carlosgj/openEEG/Eagle/Pinout.xlsx

1 | AGND
2 | VCOM
3 | VREF
4 | AGND
5 | VCOM
6 | AGND
7 | SCK
8 | SDO 0
9 | SDO 3
10 | SDO 5
11 | SDO 7
12 | SDO 9
13 | SDO 11
14 | AGND
15 | RLD
16 | AGND
17 | 5V
18 | AGND
19 | CNV
20 | SDO 1
21 | SDO 2
22 | SDO 4
23 | SDO 6
24 | SDO 8
25 | SDO 10
