carlosgj/openEEG/BOM.xlsx

Qty | Value | Device | Package | Parts | Description | PN | Price | Line
1 | 220nf | C-EUC1206 | C1206 | C1 | CAPACITOR, European symbol | 594-K224K20X7RF5TH5 (http://www.mouser.com/ProductDetail/Vishay-BC-Components/K224K20X7RF5TH5/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) | $0.19 | $0.19
8 | 100nF | C-EUC1206 | C1206 | C18, C19, C20, C21, C215, C218, C223, C230 | CAPACITOR, European symbol | 594-K104K15X7RF53L2 (http://www.mouser.com/ProductDetail/Vishay-BC-Components/K104K15X7RF53L2/) | $0.10 | $0.80
2 | 100pF | C-EUC1206 | C1206 | C206, C207 | CAPACITOR, European symbol | 594-S101K29SL0N6TK5R (http://www.mouser.com/ProductDetail/Vishay-BC-Components/S101K29SL0N6TK5R/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) | $0.11 | $0.22
1 | 10pF | C-EUC1206 | C1206 | C210 | CAPACITOR, European symbol | 594-S100K25SL0N63L6R (http://www.mouser.com/ProductDetail/Vishay-BC-Components/S100K25SL0N63L6R/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) | $0.15 | $0.15
2 | 1µF | C-EU050-024X044 | C050-024X044 | C221, C228 | CAPACITOR, European symbol | 594-K105K20X7RF5TH5 (http://www.mouser.com/ProductDetail/Vishay-BC-Components/K105K20X7RF5TH5/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) | $0.39 | $0.78
2 | 1nF | C-EUC1206 | C1206 | C224, C233 | CAPACITOR, European symbol | 594-K102J15C0GF53H5 (http://www.mouser.com/ProductDetail/Vishay-BC-Components/K102J15C0GF53H5/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) | $0.18 | $0.36
1 | 220nF 5% | C-EUC1206 | C1206 | C235 | CAPACITOR, European symbol | 810-FG22C0G1H224JNT6 (http://www.mouser.com/ProductDetail/TDK/FG22C0G1H224JNT06/) | $1.32 | $1.32
1 | 33nF 5% | C-EUC1206 | C1206 | C236 | CAPACITOR, European symbol | 810-FG24C0G1H333JNT6 (http://www.mouser.com/ProductDetail/TDK/FG24C0G1H333JNT06/) | $0.73 | $0.73
1 | INA217DW | INA217DW | DW_RPDSO-G16 | IC2 | Low-Noise, Low-Distortion INSTRUMENTATION AMPLIFIER Replacement for SSM2017 | 595-INA217AIDWT (http://www.mouser.com/ProductDetail/Texas-Instruments/INA217AIDWT/) | $6.44 | $6.44
1 | 20k | S64Y | S64Y | P203 |  | 652-3296W-1-203LF (http://www.mouser.com/ProductDetail/Bourns/3296W-1-203LF/) | $2.41 | $2.41
2 | BC557 | BC557 | TO92 | Q202, Q204 |  | 512-BC557BTA (http://www.mouser.com/ProductDetail/Fairchild-Semiconductor/BC557BTA/) | $0.21 | $0.42
2 | BC547 | BC547 | TO92 | Q206, Q208 |  | 512-BC547BTA (http://www.mouser.com/Search/ProductDetail.aspx?R=BC547BTAvirtualkey51210000virtualkey512-BC547BTA) | $0.18 | $0.36
8 | 2k2 | R-US_R1206 | R1206 | R203, R204, R209, R210, R211, R212, R216, R217 | RESISTOR, American symbol | 660-MF1/4LCT52R222J (http://www.mouser.com/ProductDetail/KOA-Speer/MF1-4LCT52R222J/) | $0.10 | $0.80
1 | 1k | R-US_R1206 | R1206 | R222 | RESISTOR, American symbol | 660-MS1/2DCT52R1001 (http://www.mouser.com/ProductDetail/KOA-Speer/MFS1-2DCT52R1001F/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) | $0.10 | $0.10
2 | 100k | R-US_R1206 | R1206 | R225, R235 | RESISTOR, American symbol | 660-MF1/4LCT52R104J (http://www.mouser.com/ProductDetail/KOA-Speer/MF1-4LCT52R104J/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) | $0.10 | $0.20
2 | 1M | R-US_R1206 | R1206 | R226, R236 | RESISTOR, American symbol | 660-MF1/4LCT52R105J (http://www.mouser.com/ProductDetail/KOA-Speer/MF1-4LCT52R105J/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) | $0.10 | $0.20
1 | 15k | R-US_R1206 | R1206 | R233 | RESISTOR, American symbol | 660-MFS1/4DCT52R1502 (http://www.mouser.com/ProductDetail/KOA-Speer/MFS1-4DCT52R1502F/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) | $0.10 | $0.10
1 | 8.2k | R-US_R1206 | R1206 | R234 | RESISTOR, American symbol | 660-MF1/4DCT52R8201F (http://www.mouser.com/ProductDetail/KOA-Speer/MF1-4DCT52R8201F/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) | $0.12 | $0.12
1 | 10k | R-US_R1206 | R1206 | R237 | RESISTOR, American symbol | 660-MF1/4LCT52R103J (http://www.mouser.com/ProductDetail/KOA-Speer/MF1-4LCT52R103J/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) | $0.10 | $0.10
1 | 7.5k | R-US_R1206 | R1206 | R3 | RESISTOR, American symbol | 660-MF1/4LCT52R752J (http://www.mouser.com/ProductDetail/KOA-Speer/MF1-4LCT52R752J/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) | $0.10 | $0.10
3 | AD8021 | AD8021 | SOIC8 | U$2, U$3, U$16 |  | 584-AD8021ARZ (http://www.mouser.com/ProductDetail/Analog-Devices/AD8021ARZ/?qs=sGAEpiMZZMv9Q1JI0Mo%2ftWybF53LRrMK) | $3.37 | $10.11
 |  |  |  |  |  |  |  | $26.01
