carlosgj/openEEG/CAD/modEEG.SLDASM

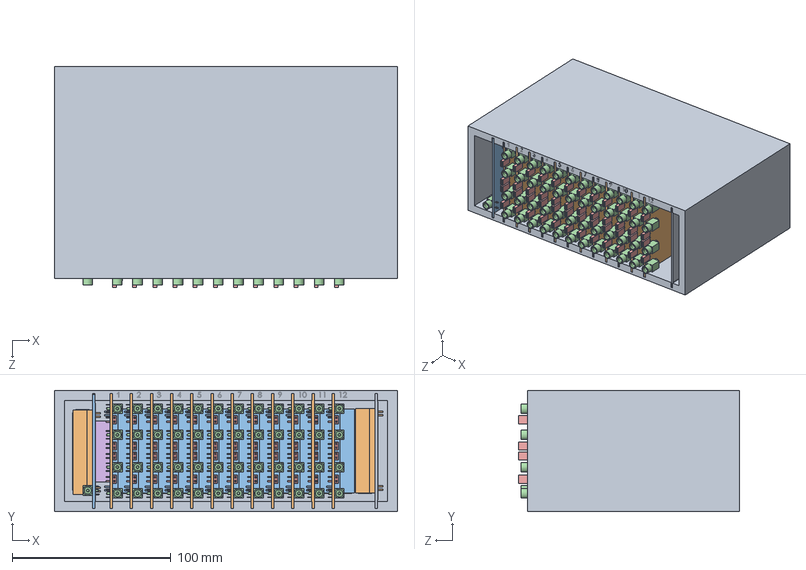
[picture p9: CAD file, 2016-11-03]
CAD/modEEG.SLDASM
215.9 x 76.2 x 138.9 mm
Enclosure
Amp PCB x 12
DB25FR x 12
EEG Jack Rt-Angle x 49
2 Pin Female Header x 48
Backplane PCB
DB25MV x 12
DB25FV x 2
Digital PCB
DB25MR x 2
Refgen PCB
