carlosgj/openEEG/CAD/Backplane.SLDASM

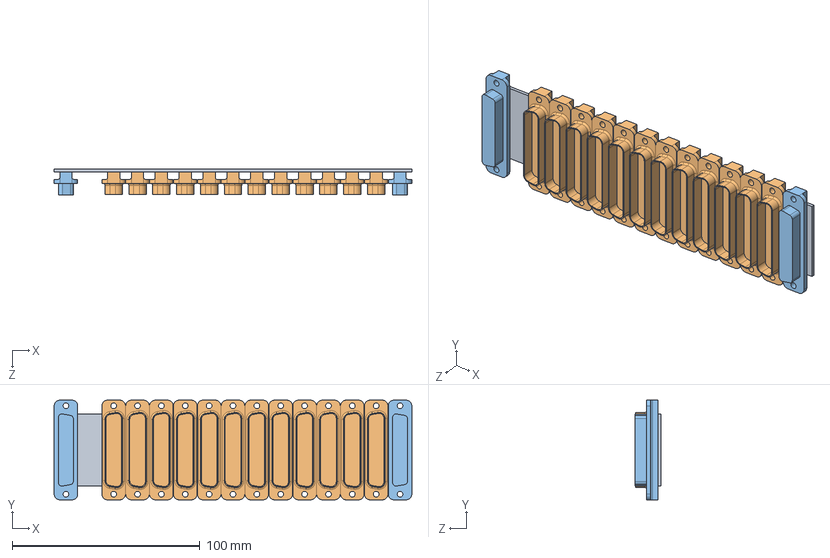
[picture p10: CAD file, 2016-11-03]
CAD/Backplane.SLDASM
190.5 x 53.0 x 13.6 mm
Backplane PCB
DB25MV x 12
DB25FV x 2
