carlosgj/openEEG/CAD/Refgen.SLDASM

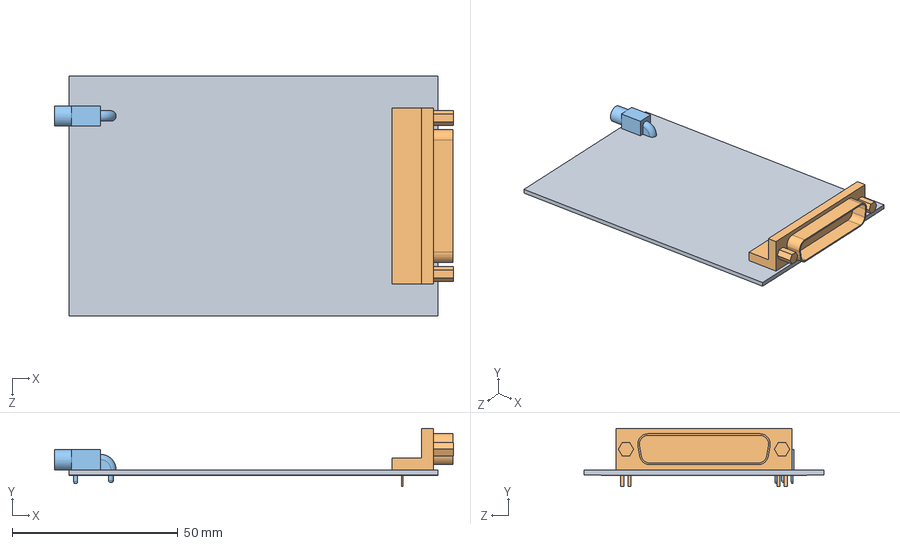
[picture p11: CAD file, 2016-11-03]
CAD/Refgen.SLDASM
120.3 x 17.5 x 72.4 mm
Refgen PCB
DB25MR
EEG Jack Rt-Angle
