carlosgj/openEEG/CAD/Amp.SLDASM

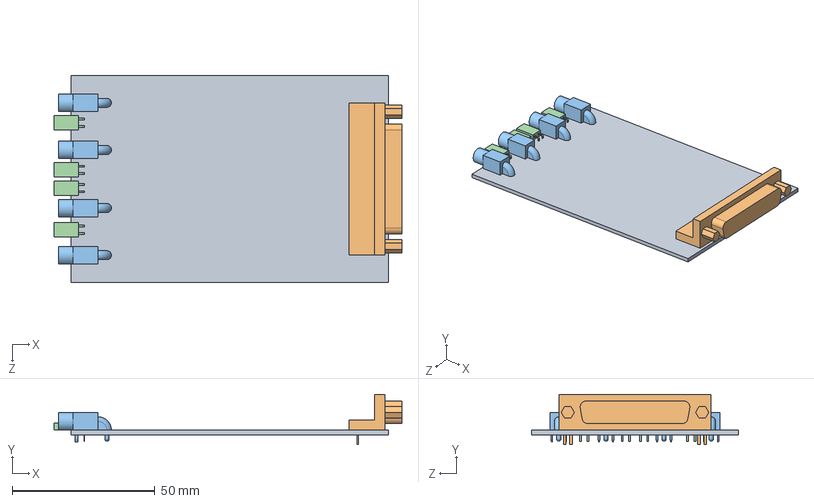
[picture p12: CAD file, 2016-11-03]
CAD/Amp.SLDASM
121.8 x 17.5 x 72.4 mm
Amp PCB
DB25FR
EEG Jack Rt-Angle x 4
2 Pin Female Header x 4
