carlosgj/openEEG/CAD/Refgen PCB.SLDPRT

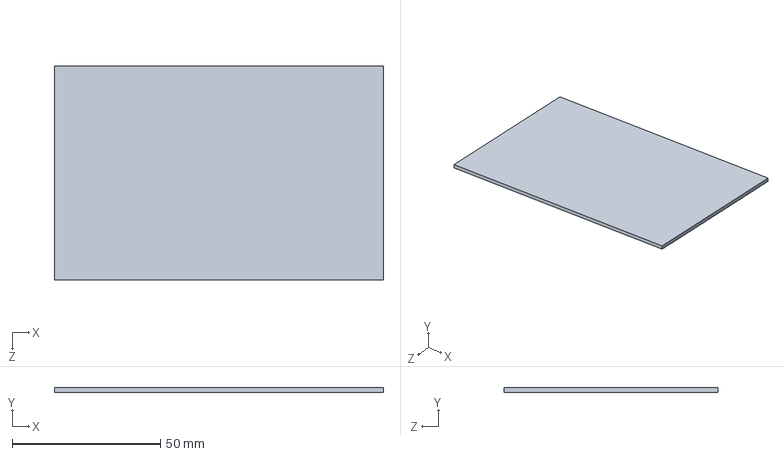
[picture p13: CAD file, 2016-11-03]
CAD/Refgen PCB.SLDPRT
111.1 x 1.64 x 72.4 mm
