carlosgj/openEEG/EEG Jack Rt-Angle.SLDPRT

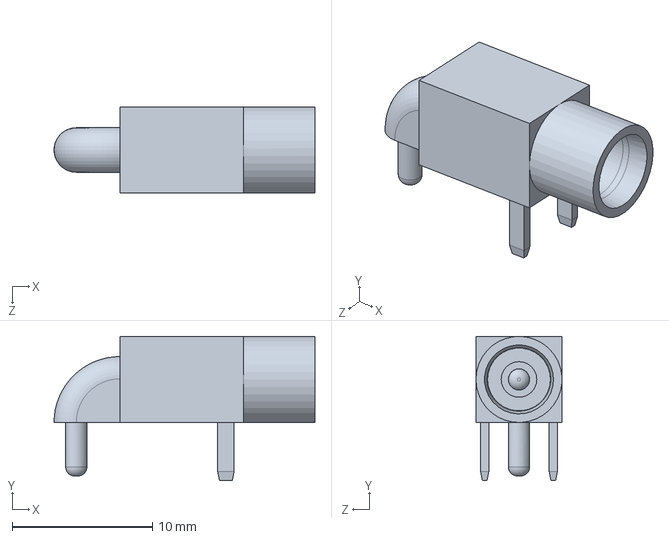
[picture p14: CAD file, 2016-11-03]
EEG Jack Rt-Angle.SLDPRT
18.6 x 10.3 x 6.13 mm
