carlosgj/openEEG/CAD/Enclosure.SLDPRT

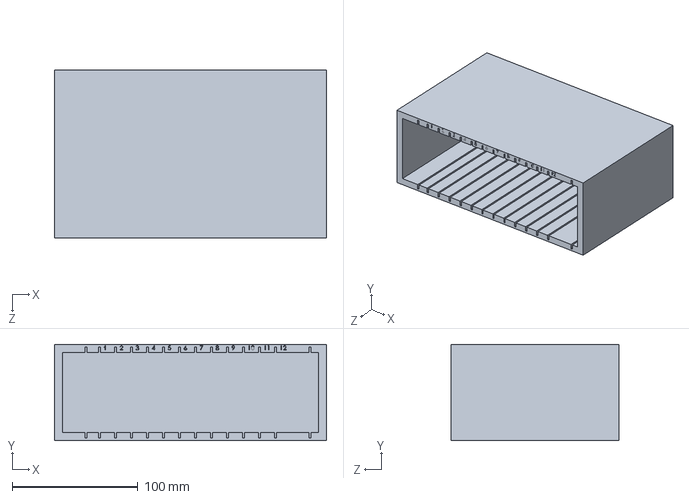
[picture p15: CAD file, 2016-11-03]
CAD/Enclosure.SLDPRT
215.9 x 76.2 x 133.4 mm
