carlosgj/openEEG/CAD/Backplane PCB.SLDPRT

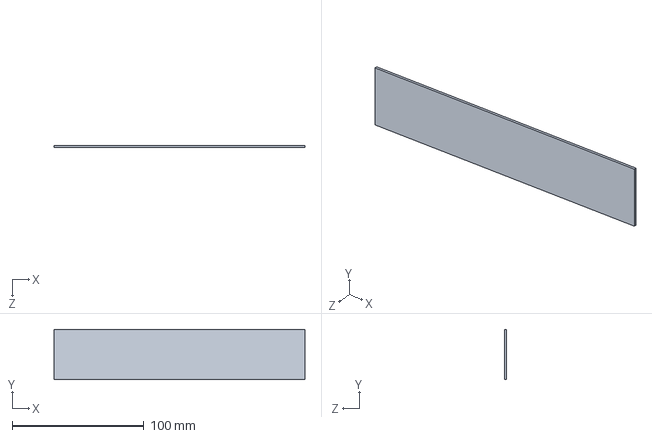
[picture p16: CAD file, 2016-11-03]
CAD/Backplane PCB.SLDPRT
190.5 x 38.1 x 1.59 mm
