carlosgj/openEEG/CAD/Amp PCB.SLDPRT

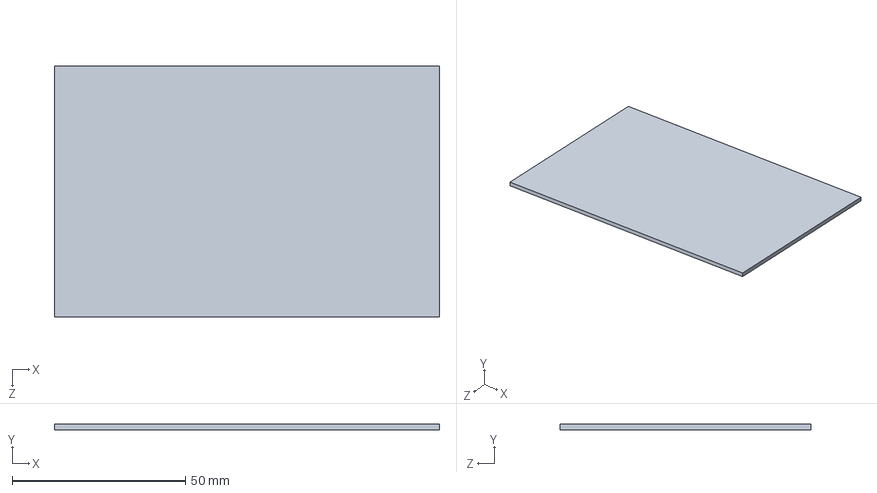
[picture p17: CAD file, 2016-11-03]
CAD/Amp PCB.SLDPRT
111.1 x 1.59 x 72.4 mm
