carlosgj/openEEG/CAD/2 Pin Female Header.SLDPRT

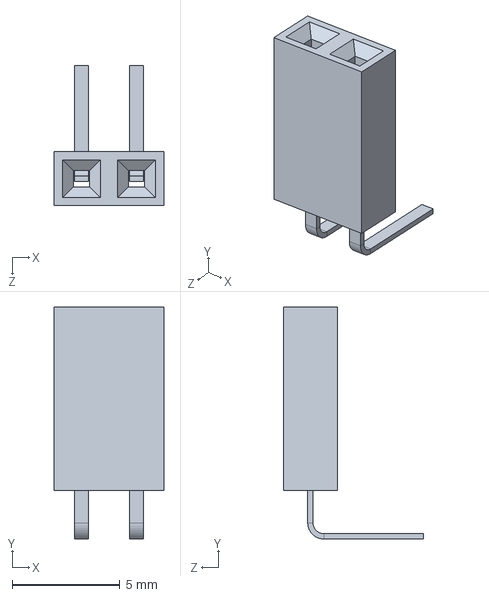
[picture p18: CAD file, 2016-11-03]
CAD/2 Pin Female Header.SLDPRT
5.08 x 10.8 x 6.50 mm
