carlosgj/openEEG/CAD/DB25FV.SLDPRT

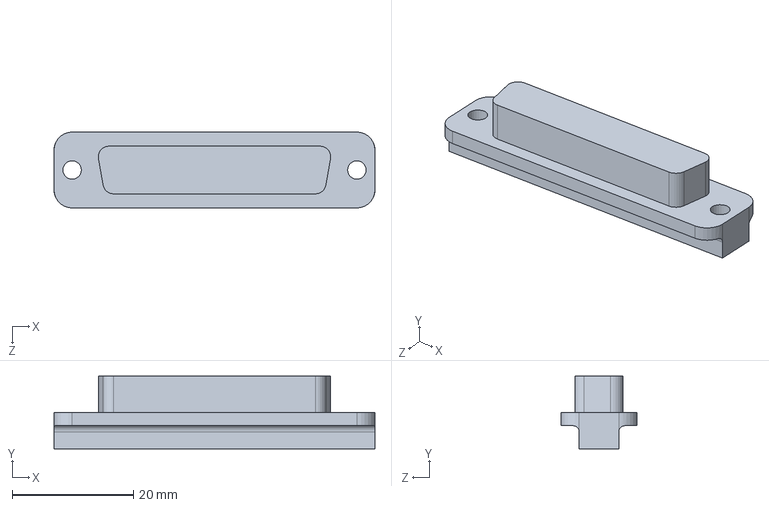
[picture p19: CAD file, 2016-11-02]
CAD/DB25FV.SLDPRT
53.0 x 12.0 x 12.6 mm
