carlosgj/openEEG/CAD/DB25MV.SLDPRT

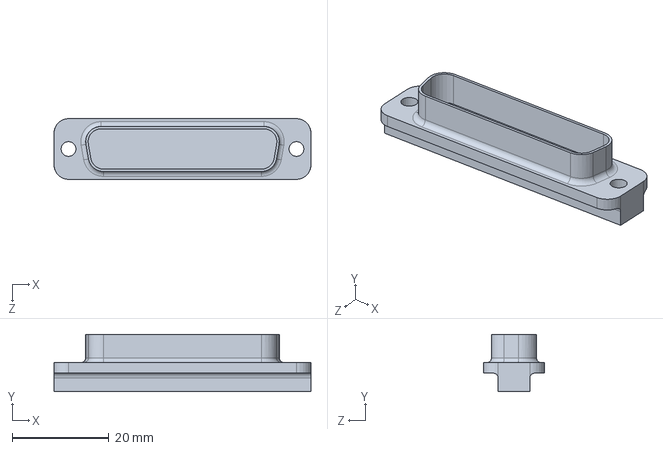
[picture p20: CAD file, 2016-11-02]
CAD/DB25MV.SLDPRT
53.0 x 11.8 x 12.6 mm
