carlosgj/openEEG/CAD/DB25MR.SLDPRT

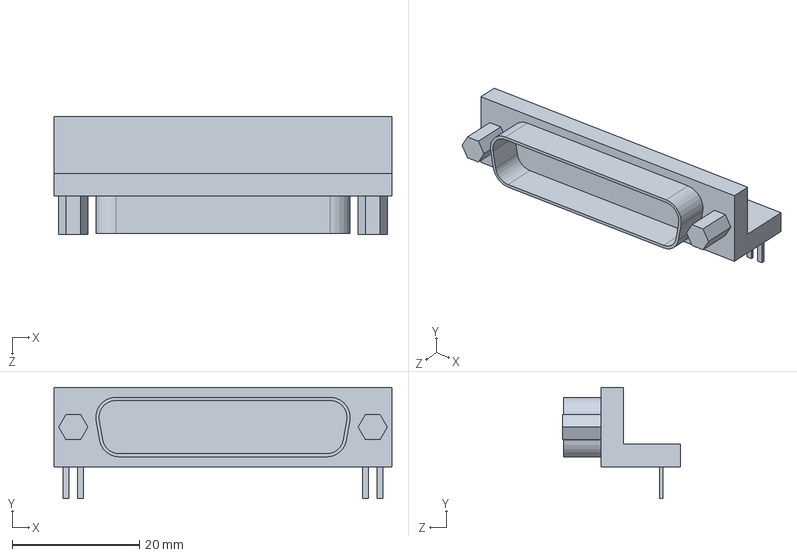
[picture p21: CAD file, 2016-11-02]
CAD/DB25MR.SLDPRT
53.1 x 17.5 x 18.5 mm
