carlosgj/openEEG/CAD/DB25FR.SLDPRT

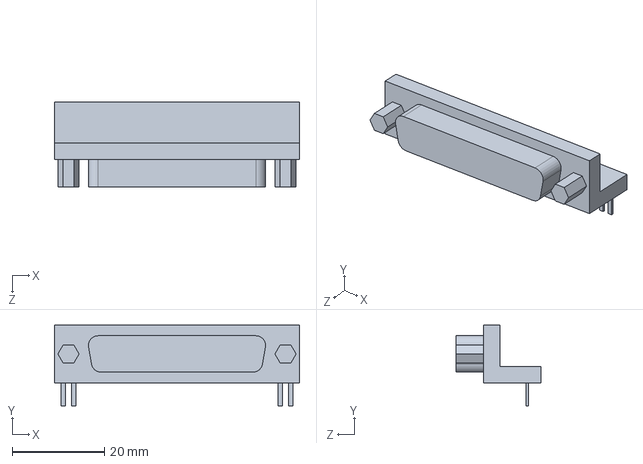
[picture p22: CAD file, 2016-11-02]
CAD/DB25FR.SLDPRT
53.1 x 17.5 x 18.5 mm
