carlosgj/openEEG/(list of files, cad)

Other CAD files:
CAD/Digital.SLDASM
modEEG.X/dist/default/production/modEEG.X.production.obj
CAD/Digital PCB.SLDPRT
CAD/DB25F.SLDPRT
