carlosgj/openEEG/Eagle/modEEGamp_v1.1 - Single.brd

## EAGLE design Eagle/modEEGamp_v1.1 - Single.brd (2017-01-04)

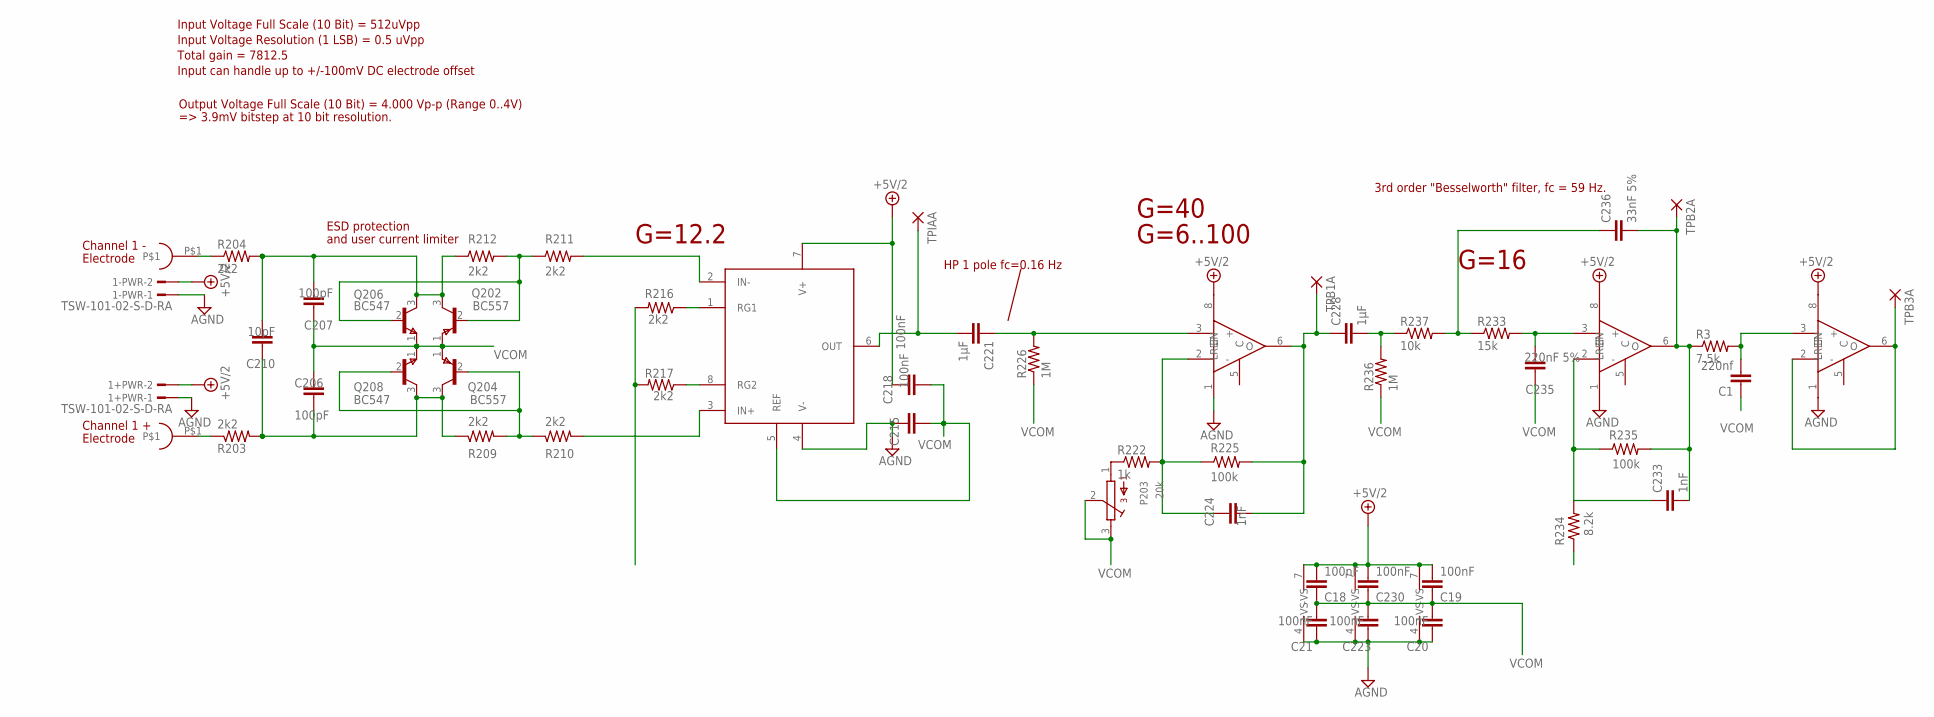
[picture p23: schematic modEEGamp_v1.1 - Single.sch]

Parts:
1+PWR, 1-PWR: TSW-101-02-S-D-RA
C1: 220nf; C1206
C1+, C1-: DIN42802
C18, C19, C20, C21, C215, C218, C223, C230: 100nF; C1206
C206, C207: 100pF; C1206
C210: 10pF; C1206
C221, C228: 1µF; C050-024X044
C224, C233: 1nF; C1206
C235: 220nF 5%; C1206
C236: 33nF 5%; C1206
P203: 20k; S64Y
Q202, Q204: BC557; TO92
Q206, Q208: BC547; TO92
R3: 7.5k; R1206
R203, R204, R209, R210, R211, R212, R216, R217: 2k2; R1206
R222: 1k; R1206
R225, R235: 100k; R1206
R226, R236: 1M; R1206
R233: 15k; R1206
R234: 8.2k; R1206
R237: 10k; R1206
TPB1A, TPB2A, TPB3A: 1,6/0,8
TPIAA: 1,6/0,8
U$1: INA217; DIL-08
U$2, U$3, U$16: AD8021; SOIC8

Connections:
+5V/2: 1+PWR.2, 1-PWR.2, C18.2, C19.2, C218.1, C230.2, U$1.7 (V+), U$2.7 (+VS), U$2.8 (EN), U$3.7 (+VS), U$3.8 (EN), U$16.7 (+VS), U$16.8 (EN)
ADIN0: TPB3A.1, U$16.2 (-), U$16.6 (O)
AGND: 1+PWR.1, 1-PWR.1, C20.1, C21.1, C215.1, C223.1, U$1.4 (V-), U$2.1 (LREF), U$2.4 (-VS), U$3.1 (LREF), U$3.4 (-VS), U$16.1 (LREF), U$16.4 (-VS)
unnamed: R216.1, U$1.1 (RG1)
unnamed: R217.1, U$1.8 (RG2)
unnamed: C233.2, C236.2, R3.1, R235.2, TPB2A.1, U$3.6 (O)
unnamed: C1-.P$1, R204.1
unnamed: C1.2, R3.2, U$16.3 (+)
unnamed: C1+.P$1, R203.1
unnamed: R216.2, R217.2
unnamed: R211.2, U$1.2 (IN-)
unnamed: C221.2, TPIAA.1, U$1.6 (OUT)
unnamed: R210.2, U$1.3 (IN+)
unnamed: C221.1, R226.2, U$2.3 (+)
unnamed: Q202.2 (B), Q206.2 (B), R211.1, R212.2
unnamed: C207.2, C210.2, Q202.3 (C), Q206.3 (C), R204.2, R212.1
unnamed: C224.1, R222.2, R225.1, U$2.2 (-)
unnamed: Q204.2 (B), Q208.2 (B), R209.2, R210.1
unnamed: P203.1, R222.1
unnamed: C224.2, C228.1, R225.2, TPB1A.1, U$2.6 (O)
unnamed: C206.1, C210.1, Q204.3 (C), Q208.3 (C), R203.2, R209.1
unnamed: C233.1, R234.2, R235.1, U$3.2 (-)
unnamed: C228.2, R236.2, R237.1
unnamed: C236.1, R233.1, R237.2
unnamed: C235.2, R233.2, U$3.3 (+)
VCOM: C1.1, C18.1, C19.1, C20.2, C21.2, C206.2, C207.1, C215.2, C218.2, C223.2, C230.1, C235.1, P203.2, P203.3, Q202.1 (E), Q204.1 (E), Q206.1 (E), Q208.1 (E), R226.1, R234.1, R236.1, U$1.5 (REF)

Notes on the sheet:
Electrode
Channel 1 -
Channel 1 +
Output Voltage Full Scale (10 Bit) = 4.000 Vp-p (Range 0..4V)
HP 1 pole fc=0.16 Hz
ESD protection
and user current limiter
G=12.2
G=16
G=40
G=6..100
Total gain = 7812.5
Input Voltage Resolution (1 LSB) = 0.5 uVpp
Input Voltage Full Scale (10 Bit) = 512uVpp
Input can handle up to +/-100mV DC electrode offset
3rd order "Besselworth" filter, fc = 59 Hz.
=> 3.9mV bitstep at 10 bit resolution.

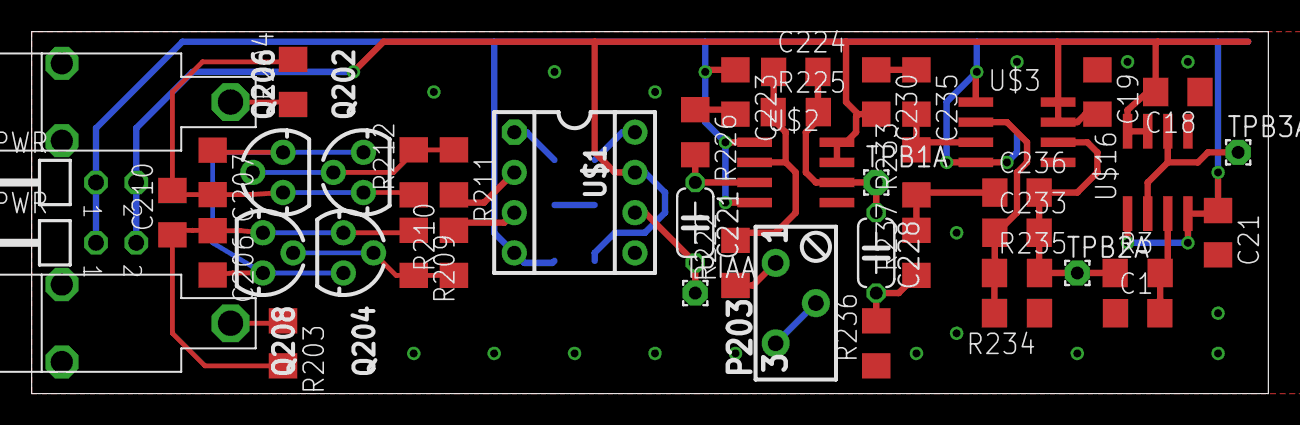
[picture p24: board modEEGamp_v1.1 - Single.brd from above]

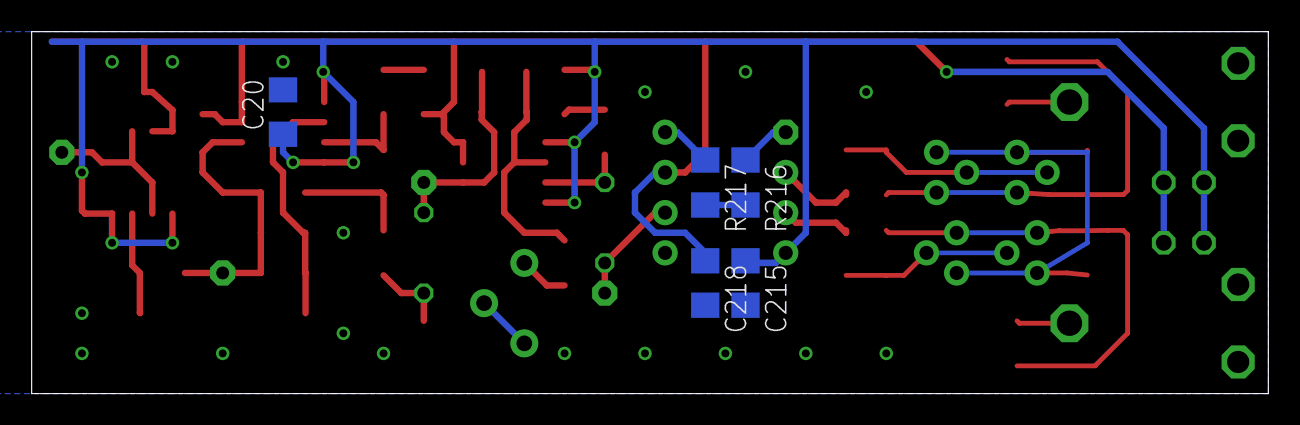
[picture p25: board modEEGamp_v1.1 - Single.brd from below]

Board: 2 copper layers, 78.1 x 22.9 mm, 52 parts (5 on the bottom side), 26 nets.
