carlosgj/openEEG/Eagle/modEEGamp_v1.1.brd

## EAGLE design Eagle/modEEGamp_v1.1.brd (2016-12-14)

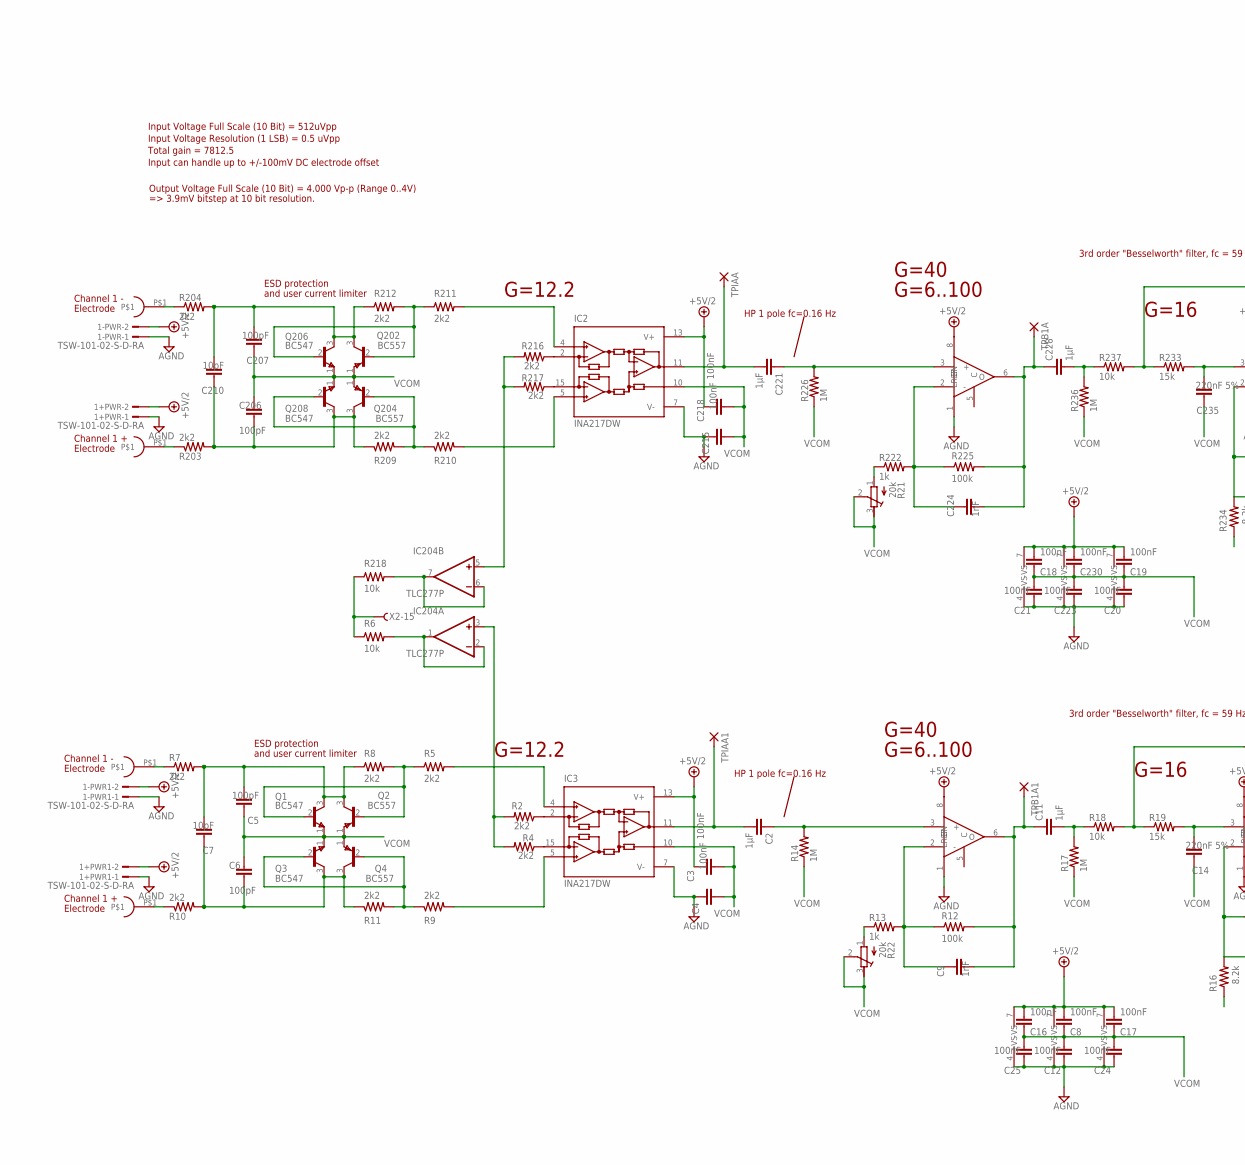
[picture p26: schematic modEEGamp_v1.1.sch, part in row 1, column 1]

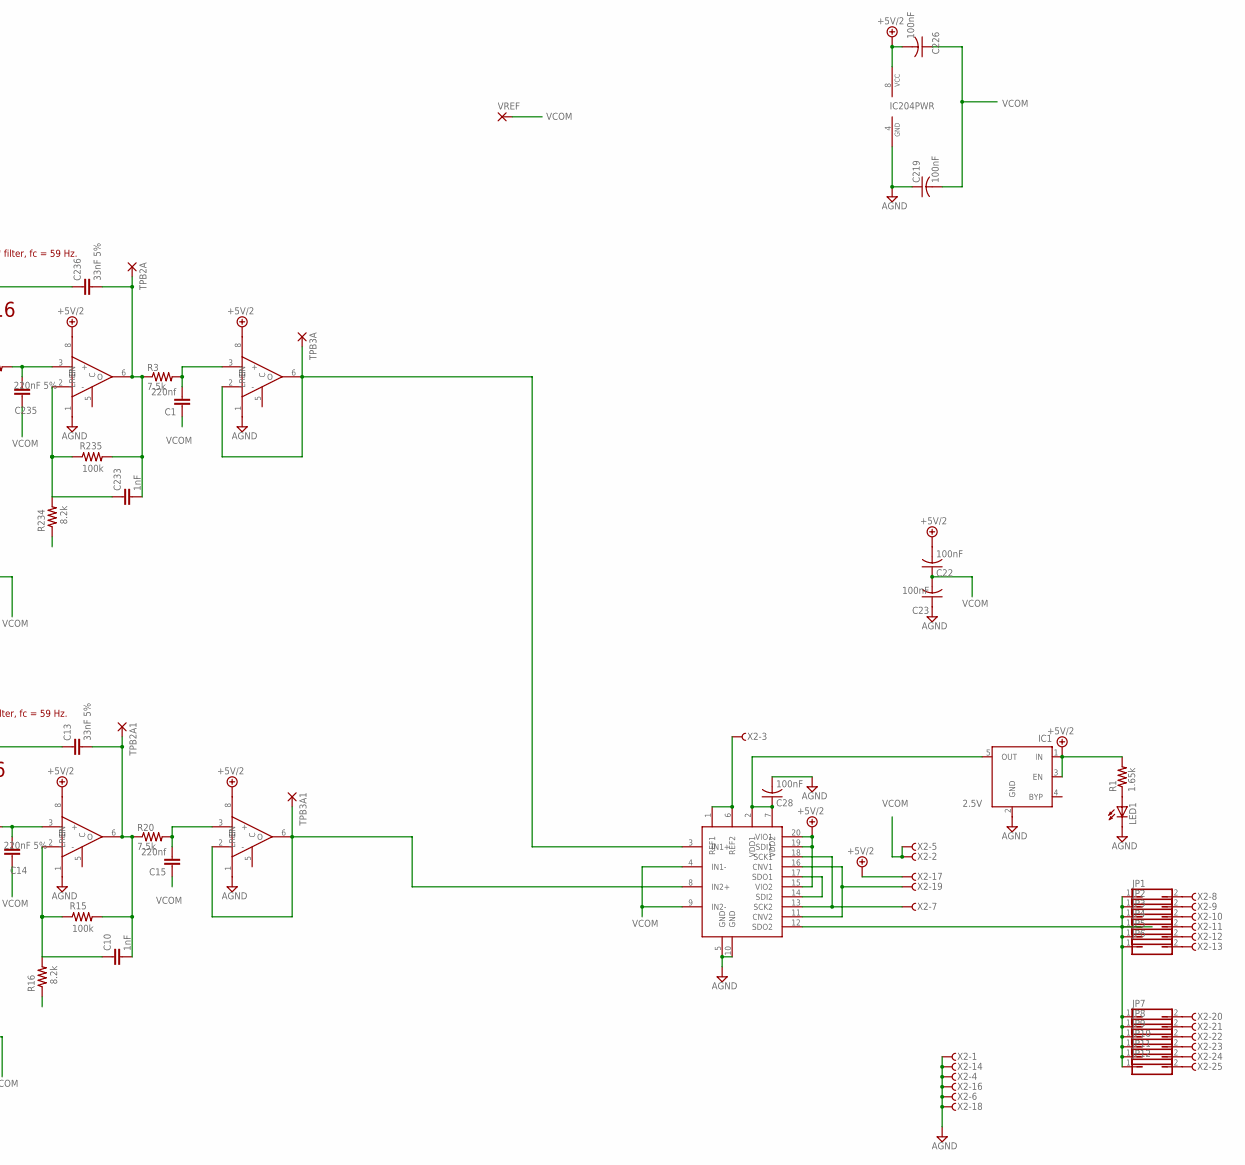
[picture p27: schematic modEEGamp_v1.1.sch, part in row 1, column 2]

Parts:
1+PWR, 1+PWR1, 1-PWR, 1-PWR1: TSW-101-02-S-D-RA
C1, C15: 220nf; C1206
C1+, C1+1, C1-, C1-1: DIN42802
C2, C11, C221, C228: 1µF; C050-024X044
C3, C4, C8, C12, C16, C17, C18, C19, C20, C21, C22, C23, C24, C25, C28, C215, C218, C219, C223, C226, C230: 100nF; C1206
C5, C6, C206, C207: 100pF; C1206
C7, C210: 10pF; C1206
C9, C10, C224, C233: 1nF; C1206
C13, C236: 33nF 5%; C1206
C14, C235: 220nF 5%; C1206
IC1: 2.5V; SOT23-5
IC2, IC3: INA217DW; DW_RPDSO-G16
IC204: TLC277P; DIL-08
JP1, JP2, JP3, JP4, JP5, JP6, JP7, JP8, JP9, JP10, JP11, JP12: JP1Q; JP1
LED1: LED3MM
Q1, Q3, Q206, Q208: BC547; TO92
Q2, Q4, Q202, Q204: BC557; TO92
R1: 1.65k; R1206
R2, R4, R5, R7, R8, R9, R10, R11, R203, R204, R209, R210, R211, R212, R216, R217: 2k2; R1206
R3, R20: 7.5k; R1206
R6, R18, R218, R237: 10k; R1206
R12, R15, R225, R235: 100k; R1206
R13, R222: 1k; R1206
R14, R17, R226, R236: 1M; R1206
R16, R234: 8.2k; R1206
R19, R233: 15k; R1206
R21, R22: 20k; RTRIM3296W
TPB1A, TPB1A1, TPB2A, TPB2A1, TPB3A, TPB3A1: 1,6/0,8
TPIAA, TPIAA1: 1,6/0,8
U$1: AD7902; QSOP20
U$10, U$12, U$20, U$30, U$31, U$36: AD8021; SOIC8
VREF: 1,6/0,8
X2: F25HPS; F25HP

Connections:
+5V/2: 1+PWR.2, 1+PWR1.2, 1-PWR.2, 1-PWR1.2, C3.1, C8.2, C16.2, C17.2, C18.2, C19.2, C22.2, C218.1, C226.2, C230.2, IC1.1 (IN), IC1.3 (EN), IC2.13 (V+), IC3.13 (V+), IC204.8 (VCC), R1.2, U$1.15 (VIO2), U$1.19 (SDI1), U$1.20 (VIO1), U$10.7 (+VS), U$10.8 (EN), U$12.7 (+VS), U$12.8 (EN), U$20.7 (+VS), U$20.8 (EN), U$30.7 (+VS), U$30.8 (EN), U$31.7 (+VS), U$31.8 (EN), U$36.7 (+VS), U$36.8 (EN), X2.17
ADIN0: TPB3A.1, U$1.3 (IN1+), U$20.2 (-), U$20.6 (O)
ADIN1: TPB3A1.1, U$1.8 (IN2+), U$36.2 (-), U$36.6 (O)
AGND: 1+PWR.1, 1+PWR1.1, 1-PWR.1, 1-PWR1.1, C4.1, C12.1, C20.1, C21.1, C23.1, C24.1, C25.1, C28.2, C215.1, C219.1, C223.1, IC1.2 (GND), IC2.7 (V-), IC3.7 (V-), IC204.4 (GND), LED1.K (C), U$1.5 (GND), U$1.10 (GND), U$10.1 (LREF), U$10.4 (-VS), U$12.1 (LREF), U$12.4 (-VS), U$20.1 (LREF), U$20.4 (-VS), U$30.1 (LREF), U$30.4 (-VS), U$31.1 (LREF), U$31.4 (-VS), U$36.1 (LREF), U$36.4 (-VS), X2.1, X2.4, X2.6, X2.14, X2.16, X2.18
CNV: U$1.11 (CNV2), U$1.16 (CNV1), X2.19
unnamed: U$1.1 (REF1), U$1.6 (REF2), X2.3
unnamed: C28.1, IC1.5 (OUT), U$1.2 (VDD1), U$1.7 (VDD2)
unnamed: JP1.1, JP2.1, JP3.1, JP4.1, JP5.1, JP6.1, JP7.1, JP8.1, JP9.1, JP10.1, JP11.1, JP12.1, U$1.12 (SDO2)
unnamed: U$1.14 (SDI2), U$1.17 (SDO1)
unnamed: C1-.P$1, R204.1
unnamed: R13.1, R22.1 (A)
unnamed: C1+.P$1, R203.1
unnamed: R21.1 (A), R222.1
unnamed: LED1.A, R1.1
unnamed: JP1.2, X2.8
unnamed: JP2.2, X2.9
unnamed: IC204.5 (+IN), R216.2, R217.2
unnamed: C233.2, C236.2, R3.1, R235.2, TPB2A.1, U$12.6 (O)
unnamed: IC2.2 (RG1), R216.1
unnamed: C1.2, R3.2, U$20.3 (+)
unnamed: IC204.3 (+IN), R2.2, R4.2
unnamed: C2.2, IC3.11 (OUT), TPIAA1.1
unnamed: IC3.4 (-IN), R5.2
unnamed: IC3.5 (+IN), R9.2
unnamed: IC2.15 (RG2), R217.1
unnamed: IC2.4 (-IN), R211.2
unnamed: Q1.2 (B), Q2.2 (B), R5.1, R8.2
unnamed: C5.2, C7.2, Q1.3 (C), Q2.3 (C), R7.2, R8.1
unnamed: Q3.2 (B), Q4.2 (B), R9.1, R11.2
unnamed: C221.2, IC2.11 (OUT), TPIAA.1
unnamed: C6.1, C7.1, Q3.3 (C), Q4.3 (C), R10.2, R11.1
unnamed: IC2.5 (+IN), R210.2
unnamed: C221.1, R226.2, U$10.3 (+)
unnamed: Q202.2 (B), Q206.2 (B), R211.1, R212.2
unnamed: C1-1.P$1, R7.1
unnamed: C1+1.P$1, R10.1
unnamed: C207.2, C210.2, Q202.3 (C), Q206.3 (C), R204.2, R212.1
unnamed: C2.1, R14.2, U$30.3 (+)
unnamed: C9.1, R12.1, R13.2, U$30.2 (-)
unnamed: IC204.1 (OUT), IC204.2 (-IN), R6.2
unnamed: JP3.2, X2.10
unnamed: C9.2, C11.1, R12.2, TPB1A1.1, U$30.6 (O)
unnamed: C224.1, R222.2, R225.1, U$10.2 (-)
unnamed: Q204.2 (B), Q208.2 (B), R209.2, R210.1
unnamed: JP4.2, X2.11
unnamed: C13.1, R18.2, R19.1
unnamed: C224.2, C228.1, R225.2, TPB1A.1, U$10.6 (O)
unnamed: C206.1, C210.1, Q204.3 (C), Q208.3 (C), R203.2, R209.1
unnamed: C14.2, R19.2, U$31.3 (+)
unnamed: C11.2, R17.2, R18.1
unnamed: C10.1, R15.1, R16.2, U$31.2 (-)
unnamed: IC3.2 (RG1), R2.1
unnamed: IC3.15 (RG2), R4.1
unnamed: C233.1, R234.2, R235.1, U$12.2 (-)
unnamed: C228.2, R236.2, R237.1
unnamed: C236.1, R233.1, R237.2
unnamed: IC204.6 (-IN), IC204.7 (OUT), R218.2
unnamed: C10.2, C13.2, R15.2, R20.1, TPB2A1.1, U$31.6 (O)
unnamed: C15.2, R20.2, U$36.3 (+)
unnamed: JP5.2, X2.12
unnamed: JP6.2, X2.13
unnamed: C235.2, R233.2, U$12.3 (+)
unnamed: JP7.2, X2.20
unnamed: JP8.2, X2.21
unnamed: JP9.2, X2.22
unnamed: JP10.2, X2.23
unnamed: JP11.2, X2.24
unnamed: JP12.2, X2.25
unnamed: R6.1, R218.1, X2.15
SCK: U$1.13 (SCK2), U$1.18 (SCK1), X2.7
VCOM: C1.1, C3.2, C4.2, C5.1, C6.2, C8.1, C12.2, C14.1, C15.1, C16.1, C17.1, C18.1, C19.1, C20.2, C21.2, C22.1, C23.2, C24.2, C25.2, C206.2, C207.1, C215.2, C218.2, C219.2, C223.2, C226.1, C230.1, C235.1, IC2.10 (REF), IC3.10 (REF), Q1.1 (E), Q2.1 (E), Q3.1 (E), Q4.1 (E), Q202.1 (E), Q204.1 (E), Q206.1 (E), Q208.1 (E), R14.1, R16.1, R17.1, R21.2 (S), R21.3 (E), R22.2 (S), R22.3 (E), R226.1, R234.1, R236.1, U$1.4 (IN1-), U$1.9 (IN2-), VREF.1, X2.2, X2.5

Notes on the sheet:
Electrode
Channel 1 -
Channel 1 +
Output Voltage Full Scale (10 Bit) = 4.000 Vp-p (Range 0..4V)
HP 1 pole fc=0.16 Hz
ESD protection
and user current limiter
G=12.2
G=16
G=40
G=6..100
Total gain = 7812.5
Input Voltage Resolution (1 LSB) = 0.5 uVpp
Input Voltage Full Scale (10 Bit) = 512uVpp
Input can handle up to +/-100mV DC electrode offset
3rd order "Besselworth" filter, fc = 59 Hz.
=> 3.9mV bitstep at 10 bit resolution.

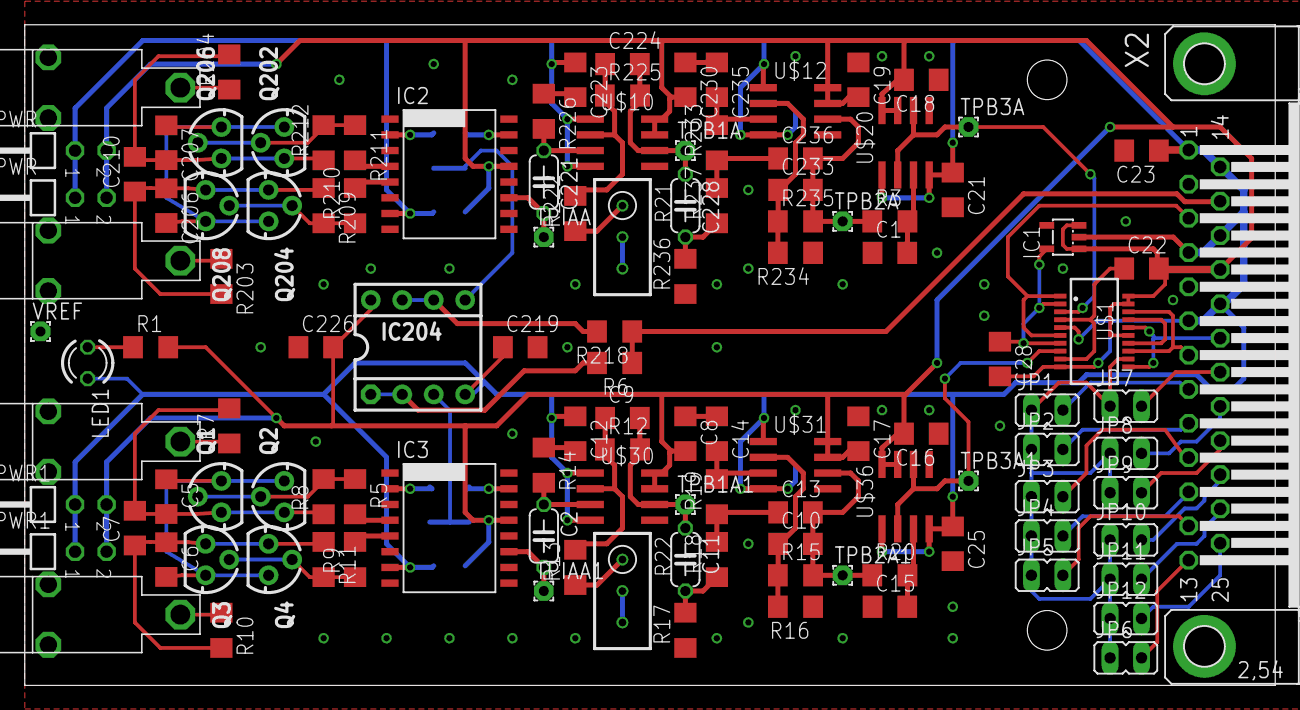
[picture p28: board modEEGamp_v1.1.brd from above]

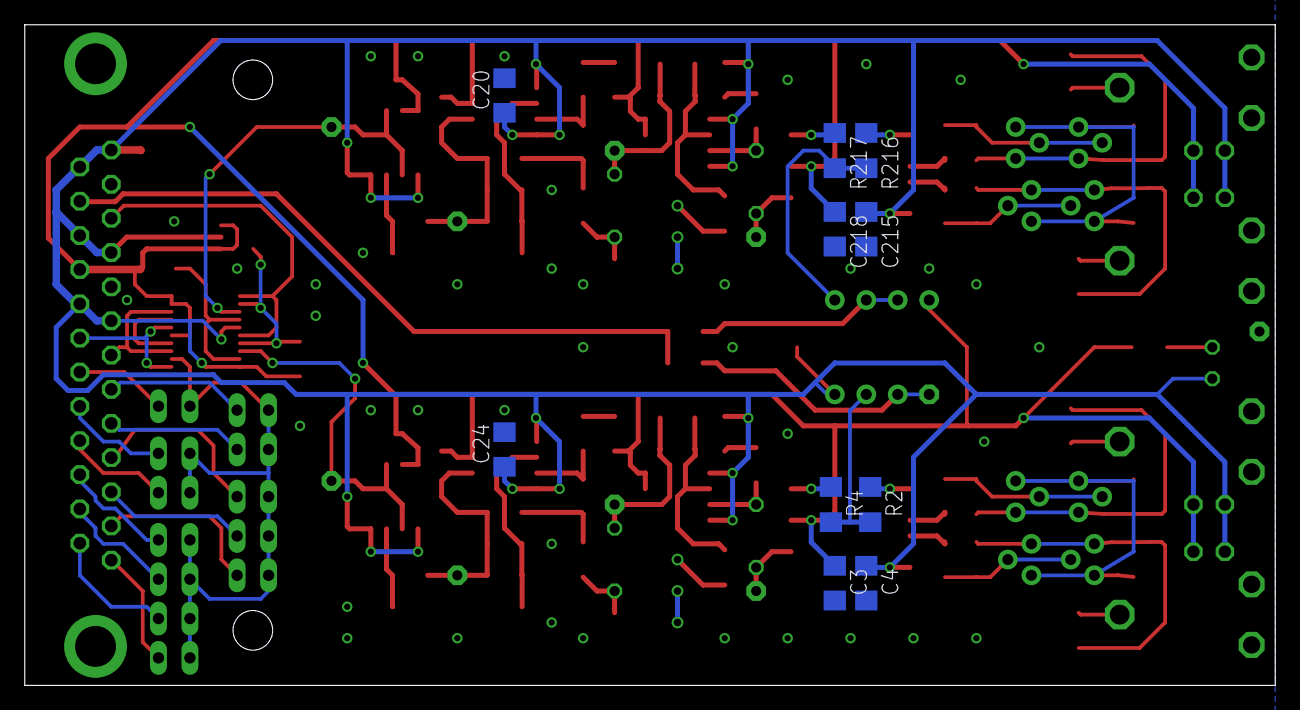
[picture p29: board modEEGamp_v1.1.brd from below]

Board: 2 copper layers, 101.0 x 53.3 mm, 130 parts (10 on the bottom side), 71 nets.
