carlosgj/openEEG/Eagle/digital.brd

## EAGLE design Eagle/digital.brd (2016-12-02)

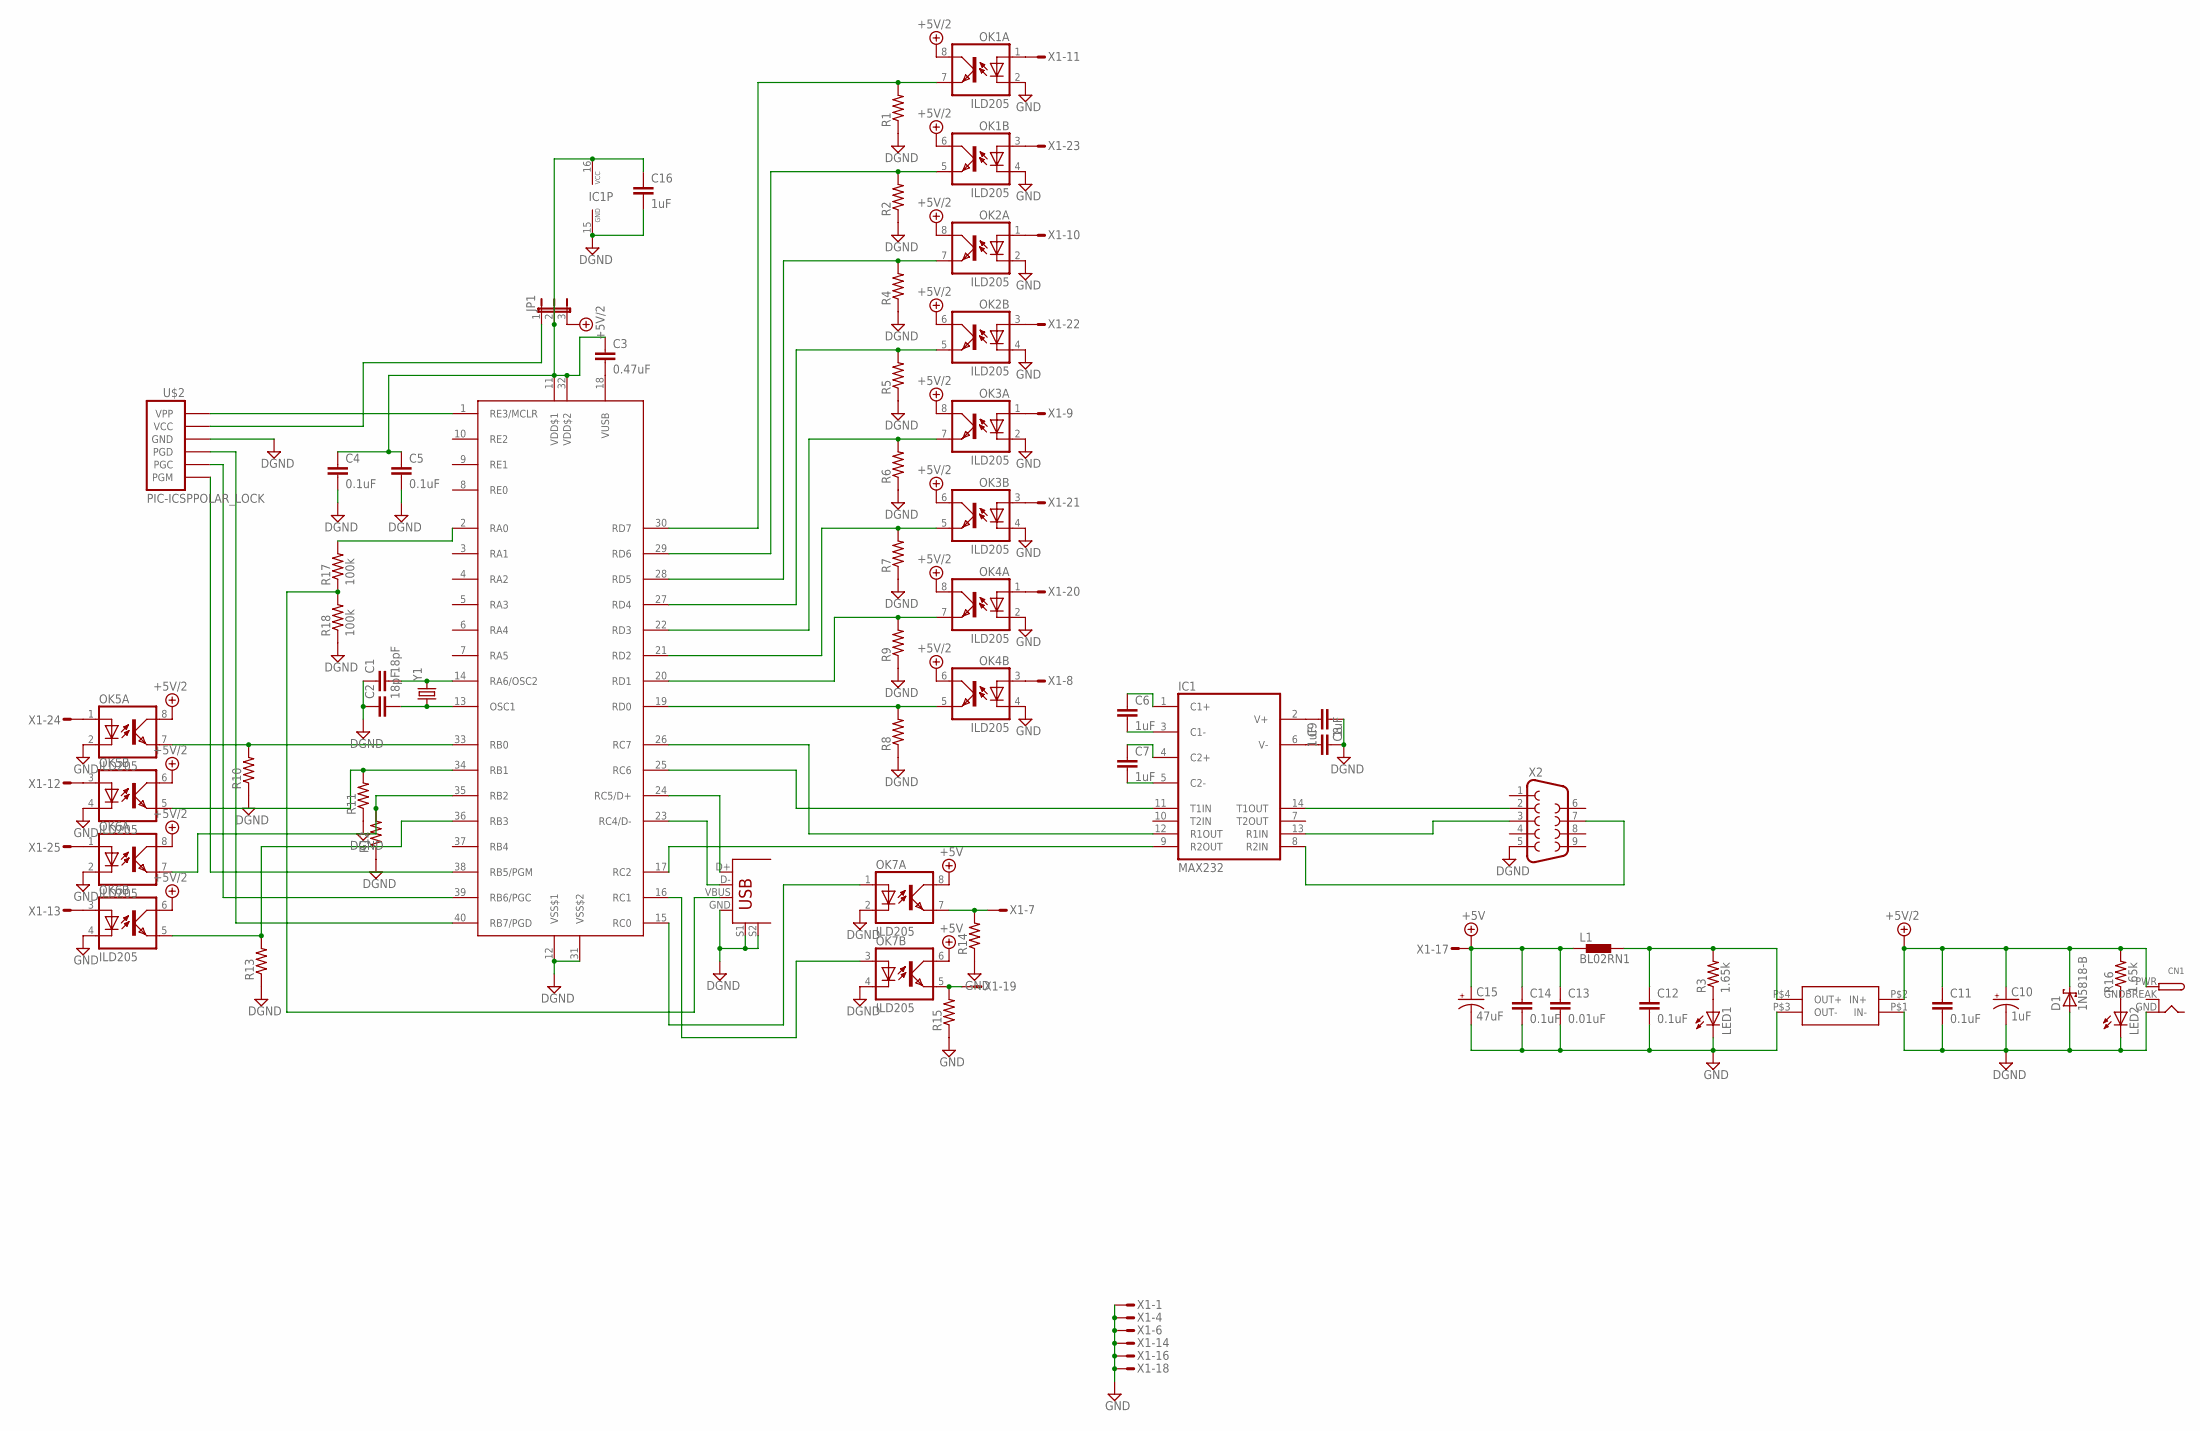
[picture p30: schematic digital.sch]

Parts:
C1, C2: 18pF; C050-025X075
C3: 0.47uF; C050-025X075
C4, C5, C11, C12, C14: 0.1uF; C050-025X075
C6, C7, C8, C9, C16: 1uF; C050-025X075
C10: 1uF; E5-8,5
C13: 0.01uF; C050-025X075
C15: 47uF; E5-8,5
CN1: DCBARRELPTH; DCJACK_2MM_PTH
D1: 1N5818-B; DO41-7.6
IC1: MAX232; DIL16
J1: USB+SHIELD; USB-B-PTH
JP1: JP2E; JP2
L1: BL02RN1
LED1, LED2: LED3MM
OK1, OK2, OK3, OK4, OK5, OK6, OK7: ILD205; SOIC08
R1, R2, R4, R5, R6, R7, R8, R9, R10, R11, R12, R13, R14, R15: R-US_0204/2V; 0204V
R3, R16: 1.65k; 0204V
R17, R18: 100k; 0204V
U$1: PIC18F4458; DIL40
U$2: PIC-ICSPPOLAR_LOCK; MOLEX-1X6_LOCK
U$3: ROL-0505S; SIP4
X1: M25HS; M25H
X2: F09HP
Y1: CRYSTALHC49US; HC49US

Connections:
+5V: C13.1, C14.1, C15.+, L1.1, OK7.6 (COL), OK7.8 (COL), X1.17
+5V/2: C10.+, C11.1, CN1.PWR, D1.C, JP1.3, OK1.6 (COL), OK1.8 (COL), OK2.6 (COL), OK2.8 (COL), OK3.6 (COL), OK3.8 (COL), OK4.6 (COL), OK4.8 (COL), OK5.6 (COL), OK5.8 (COL), OK6.6 (COL), OK6.8 (COL), R16.2, U$3.P$2 (IN+)
DGND: C1.1, C2.1, C4.2, C5.2, C8.1, C9.2, C10.-, C11.2, C16.2, CN1.GND, D1.A, IC1.15 (GND), J1.GND, J1.S1, J1.S2, LED2.K (C), OK7.2 (C), OK7.4 (C), R1.1, R2.1, R4.1, R5.1, R6.1, R7.1, R8.1, R9.1, R10.1, R11.1, R12.1, R13.1, R18.1, U$1.12 (VSS$1), U$1.31 (VSS$2), U$2.4 (GND), U$3.P$1 (IN-), X2.5
GND: C12.2, C13.2, C14.2, C15.-, LED1.K (C), OK1.2 (C), OK1.4 (C), OK2.2 (C), OK2.4 (C), OK3.2 (C), OK3.4 (C), OK4.2 (C), OK4.4 (C), OK5.2 (C), OK5.4 (C), OK6.2 (C), OK6.4 (C), R14.1, R15.1, U$3.P$3 (OUT-), X1.1, X1.4, X1.6, X1.14, X1.16, X1.18
GNDBREAK: CN1.GNDBREAK
unnamed: C1.2, U$1.14 (RA6/OSC2), Y1.2
unnamed: C2.2, U$1.13 (OSC1), Y1.1
unnamed: IC1.8 (R2IN), X2.7
unnamed: IC1.9 (R2OUT), U$1.17 (RC2)
unnamed: U$1.1 (RE3/MCLR), U$2.6 (VPP)
unnamed: U$1.38 (RB5/PGM), U$2.1 (PGM)
unnamed: U$1.39 (RB6/PGC), U$2.2 (PGC)
unnamed: U$1.40 (RB7/PGD), U$2.3 (PGD)
unnamed: C3.2, U$1.18 (VUSB)
unnamed: JP1.1, U$2.5 (VCC)
unnamed: OK1.1 (A), X1.11
unnamed: OK1.3 (A), X1.23
unnamed: OK2.1 (A), X1.10
unnamed: OK2.3 (A), X1.22
unnamed: OK1.7 (EMIT), R1.2, U$1.30 (RD7)
unnamed: OK3.1 (A), X1.9
unnamed: OK3.3 (A), X1.21
unnamed: OK4.1 (A), X1.20
unnamed: OK4.3 (A), X1.8
unnamed: OK5.1 (A), X1.24
unnamed: OK5.3 (A), X1.12
unnamed: OK6.1 (A), X1.25
unnamed: OK6.3 (A), X1.13
unnamed: OK1.5 (EMIT), R2.2, U$1.29 (RD6)
unnamed: OK2.7 (EMIT), R4.2, U$1.28 (RD5)
unnamed: C12.1, L1.2, R3.2, U$3.P$4 (OUT+)
unnamed: OK2.5 (EMIT), R5.2, U$1.27 (RD4)
unnamed: LED1.A, R3.1
unnamed: OK3.7 (EMIT), R6.2, U$1.22 (RD3)
unnamed: OK3.5 (EMIT), R7.2, U$1.21 (RD2)
unnamed: OK4.7 (EMIT), R9.2, U$1.20 (RD1)
unnamed: OK4.5 (EMIT), R8.2, U$1.19 (RD0)
unnamed: OK5.7 (EMIT), R10.2, U$1.33 (RB0)
unnamed: OK5.5 (EMIT), R11.2, U$1.34 (RB1)
unnamed: OK6.7 (EMIT), R12.2, U$1.35 (RB2)
unnamed: OK6.5 (EMIT), R13.2, U$1.36 (RB3)
unnamed: OK7.7 (EMIT), R14.2, X1.7
unnamed: OK7.5 (EMIT), R15.2, X1.19
unnamed: OK7.1 (A), U$1.15 (RC0)
unnamed: OK7.3 (A), U$1.16 (RC1)
unnamed: LED2.A, R16.1
unnamed: J1.VBUS, R17.1, R18.2
unnamed: IC1.11 (T1IN), U$1.25 (RC6)
unnamed: C3.1, C4.1, C5.1, C16.1, IC1.16 (VCC), JP1.2, U$1.11 (VDD$1), U$1.32 (VDD$2)
unnamed: IC1.12 (R1OUT), U$1.26 (RC7)
unnamed: C8.2, IC1.2 (V+)
unnamed: C9.1, IC1.6 (V-)
unnamed: C6.2, IC1.3 (C1-)
unnamed: C6.1, IC1.1 (C1+)
unnamed: C7.1, IC1.4 (C2+)
unnamed: C7.2, IC1.5 (C2-)
unnamed: IC1.13 (R1IN), X2.3
unnamed: IC1.14 (T1OUT), X2.2
unnamed: R17.2, U$1.2 (RA0)
USB_N: J1.D-, U$1.23 (RC4/D-)
USB_P: J1.D+, U$1.24 (RC5/D+)

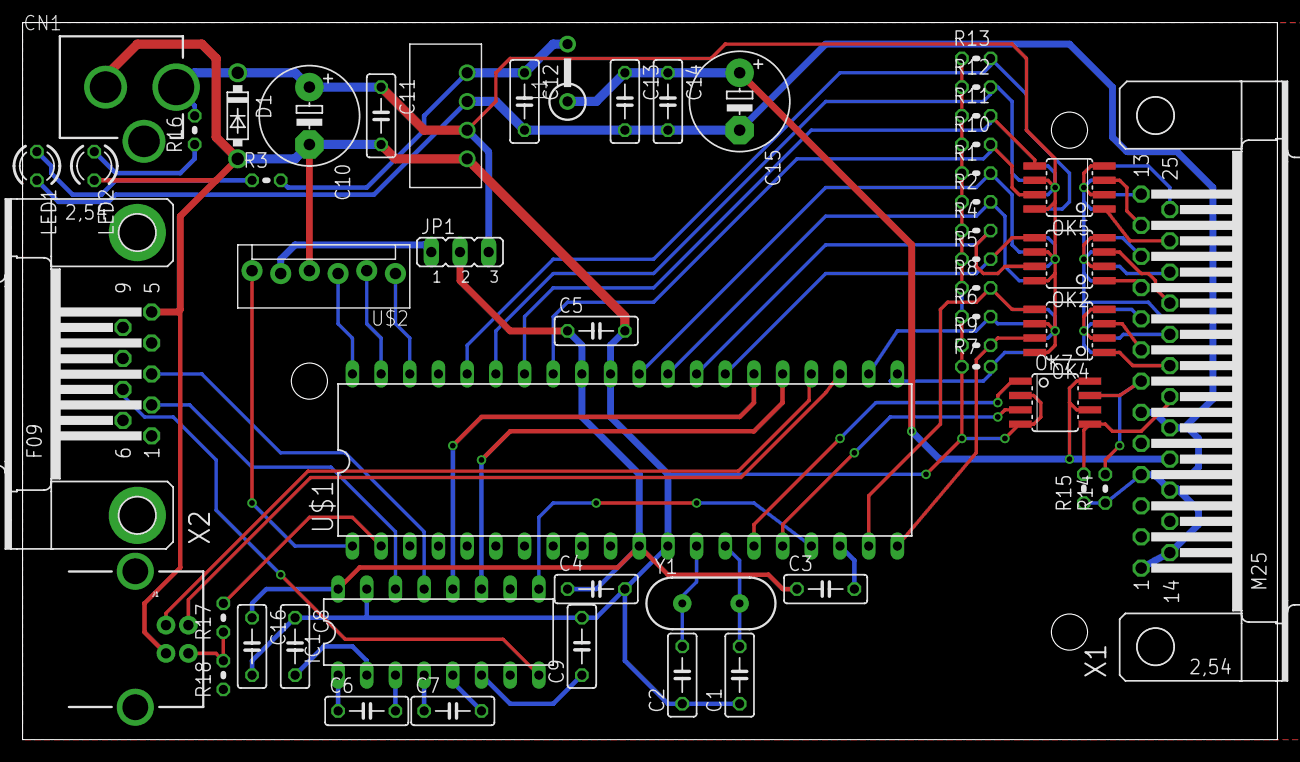
[picture p31: board digital.brd from above]

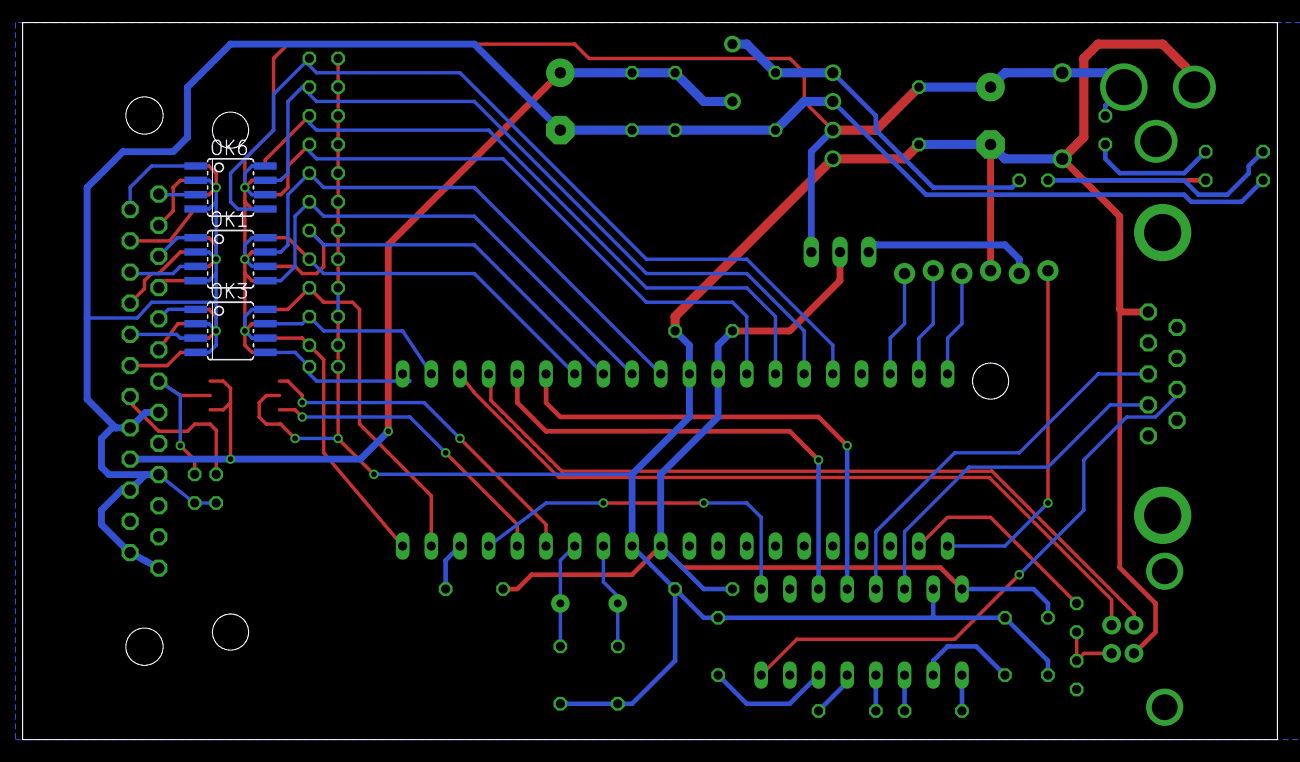
[picture p32: board digital.brd from below]

Board: 2 copper layers, 111.1 x 63.5 mm, 55 parts (3 on the bottom side), 60 nets.
