carlosgj/openEEG/Eagle/refgen.brd

## EAGLE design Eagle/refgen.brd (2016-11-09)

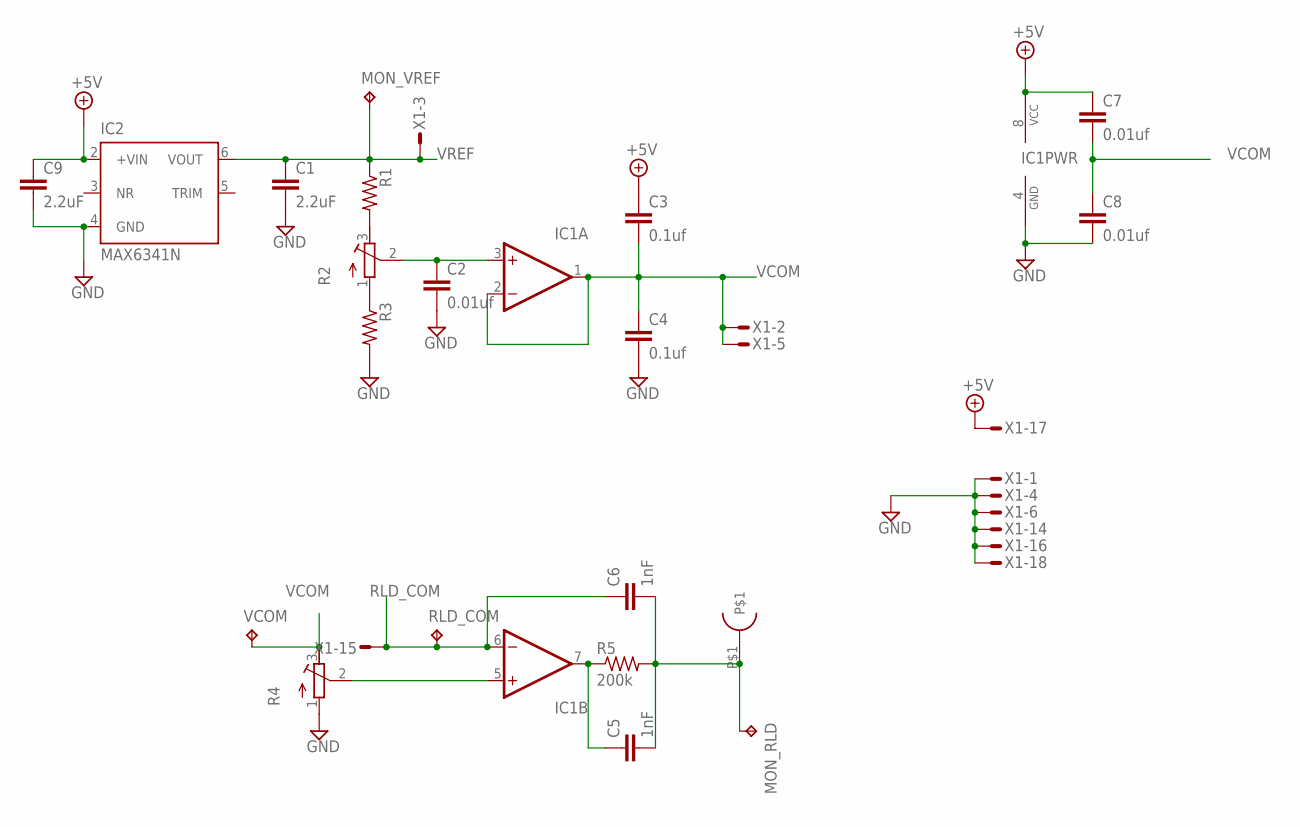
[picture p33: schematic refgen.sch]

Parts:
C1, C9: 2.2uF; C050-025X075
C2, C7, C8: 0.01uf; C050-025X075
C3, C4: 0.1uf; C050-025X075
C5, C6: 1nF; C050-025X075
IC1: TLC277P; DIL-08
IC2: MAX6341N; DIL08
MON_RLD: TPPAD1-17; P1-17
MON_VREF: TPPAD1-17; P1-17
R1, R3: R-US_0204/2V; 0204V
R2, R4: R-TRIMM3296W; RTRIM3296W
R5: 200k; 0204V
RLD_COM: TPPAD1-17; P1-17
RLD_OUT: DIN42802
VCOM: TPPAD1-17; P1-17
X1: M25HPS; M25HP

Connections:
+5V: C3.1, C7.1, C9.1, IC1.8 (VCC), IC2.2 (+VIN), X1.17
GND: C1.2, C2.2, C4.2, C8.2, C9.2, IC1.4 (GND), IC2.4 (GND), R3.2, R4.1 (A), X1.1, X1.4, X1.6, X1.14, X1.16, X1.18
unnamed: C5.1, IC1.7 (OUT), R5.1
unnamed: R1.2, R2.3 (E)
unnamed: R2.1 (A), R3.1
unnamed: C2.1, IC1.3 (+IN), R2.2 (S)
unnamed: C5.2, C6.2, MON_RLD.TP, R5.2, RLD_OUT.P$1
unnamed: IC1.5 (+IN), R4.2 (S)
RLD_COM: C6.1, IC1.6 (-IN), RLD_COM.TP, X1.15
VCOM: C3.2, C4.1, C7.2, C8.1, IC1.1 (OUT), IC1.2 (-IN), R4.3 (E), VCOM.TP, X1.2, X1.5
VREF: C1.1, IC2.6 (VOUT), MON_VREF.TP, R1.1, X1.3

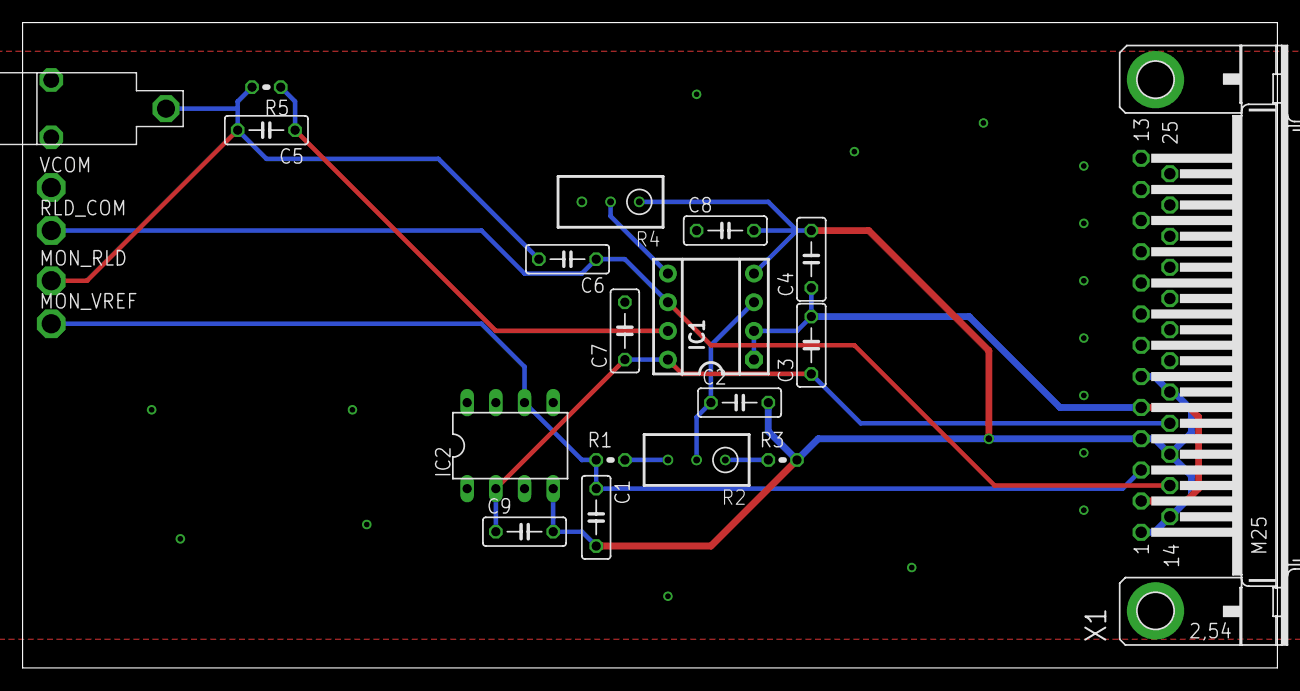
[picture p34: board refgen.brd from above]

Board: 2 copper layers, 111.1 x 57.1 mm, 22 parts (0 on the bottom side), 11 nets.
