carlosgj/openEEG/Eagle/Active Electrode.brd

## EAGLE design Eagle/Active Electrode.brd (2016-11-03)

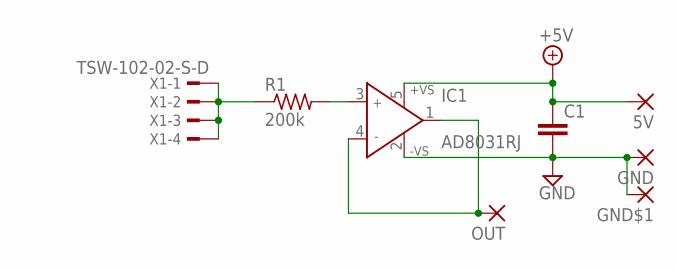
[picture p35: schematic Active Electrode.sch]

Parts:
5V: 1,6/0,9
C1: C-EUC1206; C1206
GND: 1,6/0,9
GND$1: 1,6/0,9
IC1: AD8031RJ; SOT23-5
OUT: 1,6/0,9
R1: 200k; M1206
X1: TSW-102-02-S-D

Connections:
+5V: 5V.1, C1.1, IC1.5 (+VS)
GND: C1.2, GND.1, GND$1.1, IC1.2 (-VS)
unnamed: R1.1, X1.1, X1.2, X1.3, X1.4
unnamed: IC1.3 (IN+), R1.2
unnamed: IC1.1 (OUT), IC1.4 (IN-), OUT.1

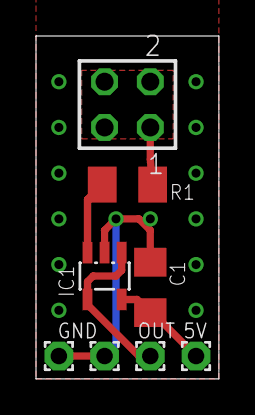
[picture p36: board Active Electrode.brd from above]

Board: 2 copper layers, 10.2 x 19.1 mm, 8 parts (0 on the bottom side), 5 nets.
