carlosgj/openEEG/Eagle/Backplane.brd

## EAGLE design Eagle/Backplane.brd (2016-11-02)

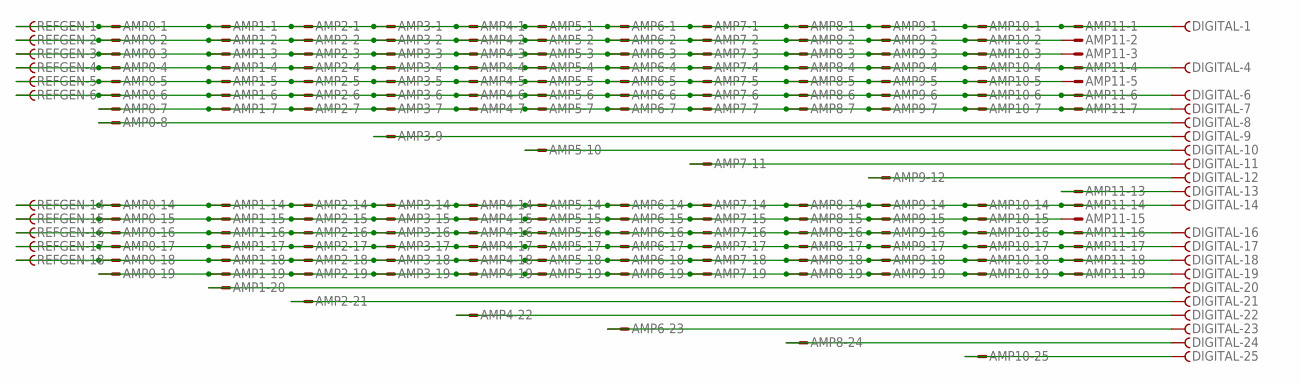
[picture p37: schematic Backplane.sch]

Parts:
AMP0, AMP1, AMP2, AMP3, AMP4, AMP5, AMP6, AMP7, AMP8, AMP9, AMP10, AMP11: M25VPS; M25VP
DIGITAL: F25VPS; F25VP
REFGEN: F25VPS; F25VP

Connections:
unnamed: AMP0.1, AMP1.1, AMP2.1, AMP3.1, AMP4.1, AMP5.1, AMP6.1, AMP7.1, AMP8.1, AMP9.1, AMP10.1, AMP11.1, DIGITAL.1, REFGEN.1
unnamed: AMP0.2, AMP1.2, AMP2.2, AMP3.2, AMP4.2, AMP5.2, AMP6.2, AMP7.2, AMP8.2, AMP9.2, AMP10.2, AMP11.2, REFGEN.2
unnamed: AMP0.3, AMP1.3, AMP2.3, AMP3.3, AMP4.3, AMP5.3, AMP6.3, AMP7.3, AMP8.3, AMP9.3, AMP10.3, AMP11.3, REFGEN.3
unnamed: AMP0.4, AMP1.4, AMP2.4, AMP3.4, AMP4.4, AMP5.4, AMP6.4, AMP7.4, AMP8.4, AMP9.4, AMP10.4, AMP11.4, DIGITAL.4, REFGEN.4
unnamed: AMP0.5, AMP1.5, AMP2.5, AMP3.5, AMP4.5, AMP5.5, AMP6.5, AMP7.5, AMP8.5, AMP9.5, AMP10.5, AMP11.5, REFGEN.5
unnamed: AMP0.8, DIGITAL.8
unnamed: AMP3.9, DIGITAL.9
unnamed: AMP4.22, DIGITAL.22
unnamed: AMP2.21, DIGITAL.21
unnamed: AMP1.20, DIGITAL.20
unnamed: AMP0.19, AMP1.19, AMP2.19, AMP3.19, AMP4.19, AMP5.19, AMP6.19, AMP7.19, AMP8.19, AMP9.19, AMP10.19, AMP11.19, DIGITAL.19
unnamed: AMP5.10, DIGITAL.10
unnamed: AMP0.6, AMP1.6, AMP2.6, AMP3.6, AMP4.6, AMP5.6, AMP6.6, AMP7.6, AMP8.6, AMP9.6, AMP10.6, AMP11.6, DIGITAL.6, REFGEN.6
unnamed: AMP0.7, AMP1.7, AMP2.7, AMP3.7, AMP4.7, AMP5.7, AMP6.7, AMP7.7, AMP8.7, AMP9.7, AMP10.7, AMP11.7, DIGITAL.7
unnamed: AMP6.23, DIGITAL.23
unnamed: AMP7.11, DIGITAL.11
unnamed: AMP8.24, DIGITAL.24
unnamed: AMP9.12, DIGITAL.12
unnamed: AMP0.14, AMP1.14, AMP2.14, AMP3.14, AMP4.14, AMP5.14, AMP6.14, AMP7.14, AMP8.14, AMP9.14, AMP10.14, AMP11.14, DIGITAL.14, REFGEN.14
unnamed: AMP0.15, AMP1.15, AMP2.15, AMP3.15, AMP4.15, AMP5.15, AMP6.15, AMP7.15, AMP8.15, AMP9.15, AMP10.15, AMP11.15, REFGEN.15
unnamed: AMP10.25, DIGITAL.25
unnamed: AMP0.16, AMP1.16, AMP2.16, AMP3.16, AMP4.16, AMP5.16, AMP6.16, AMP7.16, AMP8.16, AMP9.16, AMP10.16, AMP11.16, DIGITAL.16, REFGEN.16
unnamed: AMP0.17, AMP1.17, AMP2.17, AMP3.17, AMP4.17, AMP5.17, AMP6.17, AMP7.17, AMP8.17, AMP9.17, AMP10.17, AMP11.17, DIGITAL.17, REFGEN.17
unnamed: AMP0.18, AMP1.18, AMP2.18, AMP3.18, AMP4.18, AMP5.18, AMP6.18, AMP7.18, AMP8.18, AMP9.18, AMP10.18, AMP11.18, DIGITAL.18, REFGEN.18
unnamed: AMP11.13, DIGITAL.13

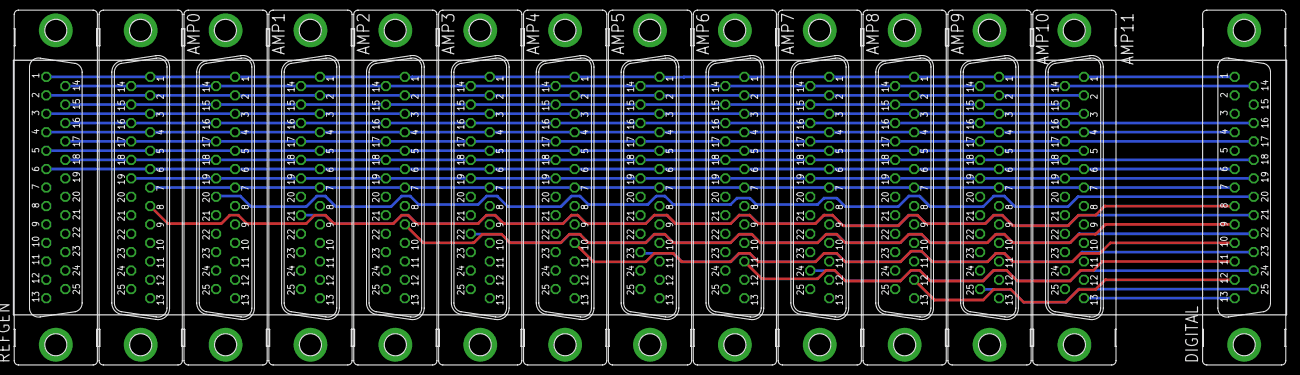
[picture p38: board Backplane.brd from above]

Board: 2 copper layers, 190.5 x 38.1 mm, 14 parts (0 on the bottom side), 25 nets.
