carlosgj/openEEG/(commit log)

2016-08-15 New version!
    [modEEGamp_v1.1.brd, modEEGamp_v1.1.sch]
2016-10-25 Added control board
    [digital.brd, digital.sch, modEEGamp_v1.1.brd, modEEGamp_v1.1.sch]
2016-10-25 Finished digital board
    [digital.brd, digital.sch, modEEGamp_v1.1.brd, modEEGamp_v1.1.sch]
2016-10-31 Switched to DB25
    [modEEGamp_v1.1.brd, modEEGamp_v1.1.sch]
2016-10-31 Finished up chanes to DB25
    [Backplane.brd, Backplane.sch, Pinout.xlsx, digital.sch, modEEGamp_v1.1.brd, modEEGamp_v1.1.sch, modEEGdigital_v1.1.brd, modEEGdigital_v1.1.sch]
2016-11-01 Added optoisolators
    [digital.brd, digital.sch]
2016-11-02 Corrected connector positions
    [Backplane.brd, digital.brd, modEEGamp_v1.1.brd]
2016-11-03 Added DIN 42802 jacks & power for active electrodes
    [EEG Jack Rt-Angle.SLDPRT, modEEGamp_v1.1.brd, modEEGamp_v1.1.sch, refgen.brd, refgen.sch]
2016-11-03 Active electrodes
    [2 Pin Female Header.SLDPRT, Active Electrode.brd, Active Electrode.sch, Amp PCB.SLDPRT, Amp.SLDASM, modEEG.SLDASM]
2016-11-03 Updated backplane spacing
    [Backplane PCB.SLDPRT, Backplane.SLDASM, Enclosure.SLDPRT, Refgen PCB.SLDPRT, Refgen.SLDASM, modEEG.SLDASM]
2016-11-03 Added indicator LEDs
    [digital.brd, digital.sch, modEEGamp_v1.1.brd, modEEGamp_v1.1.sch]
2016-11-03 Updated resistor values
    [digital.brd, digital.sch, modEEGamp_v1.1.brd, modEEGamp_v1.1.sch]
2016-11-06 Added 232 interface
    [digital.brd, digital.sch]
2016-11-06 Code work
    [modEEG.X.production.obj]
2016-11-07 More code work
    [Baud calcs.xlsx, modEEG.X.production.obj]
2016-11-07 Changed USB to differential pair
    [Baud calcs.xlsx, digital.brd, digital.sch]
2016-11-07 Added ethernet module
    [digital.brd, digital.sch]
2016-11-07 Added level shifting
    [digital.brd, digital.sch]
2016-11-08 Added RTS
    [digital.brd, digital.sch, modEEG.X.production.obj]
2016-11-08 Shrunk boards
    [digital.brd, modEEGamp_v1.1.brd]
2016-11-08 Board shrink
    [modEEGamp_v1.1 - Single.brd, modEEGamp_v1.1 - Single.sch, modEEGamp_v1.1.brd, modEEGamp_v1.1.sch]
2016-11-08 Board updates
    [digital.brd]
2016-11-22 Added mounting holes
    [modEEGamp_v1.1.brd]
2016-12-02 Added connection monitor
    [digital.brd, digital.sch]
2016-12-14 Board updates (jumpers)
    [BOM.xlsx, Single BOM.csv, modEEGamp_v1.1.brd, modEEGamp_v1.1.sch]
2016-12-14 Part numbers
    [modEEGamp_v1.1.brd, modEEGamp_v1.1.sch]
